goncalo3377/Tese/Document_Dissertacao/README.md

# README #

*EN Dissertation  LaTeX Template - Version 0.1 (JUL/2019)*

This template explains the main formatting rules to apply to a Master Dissertation work for EN.

**You can fork this repository to make your own dissertation based on this template.**

This template is based on MastersDoctoralThesis version 1.2 by Vel (vel@latextemplates.com) and Johannes Böttcher, downloaded from [LaTeXTemplates](http://www.LaTeXTemplates.com) in November/2015. Adapted to TMDEI/ISEP style (Dec/2015) by Nuno Pereira and Paulo Baltarejo (DEI/ISEP).

## How do I get set up? ##

Just fork the repository and use it. You will need LaTeX tools installed in your system, with the packages needed by the template (more details bellow).

### LaTeX Distribution

LaTeX is available for many systems including Windows, Linux and Mac OS X. Check the webpage for the LaTex project for more information: <https://latex-project.org/ftp.html>.

Make sure you have the following tools installed: **pdflatex**, **makeglossaries**, **biber**, **latexmk**.

### LaTeX Packages Needed

| Package | Obs |
|---|-----|
|babel|Required for automatically changing names of document elements to languages besides english|
|scrbase|Required for handling language-dependent names of sections/document elements|
|scrhack|Loads fixes for various packages|
|setspace|Required for changing line spacing|
|longtable|Required for tables that span multiple pages (used in the symbols, abbreviations and physical constants pages)|
|siunitx|Required for \SI commands|
|graphicx|Required to include images|
|xcolor|Required for extra color names|
|booktabs|Required for better table rules|
|inputenc|Required for inputting portuguese characters|
|fontenc|Output font encoding for portuguese characters|
|csquotes|Required to generate language-dependent quotes in the bibliography|
|cmbright|Default font: CM Bright, lighter sans-serif variant of Computer Modern Sans Serif|
|algorithm|Required for algorithms|
|algpseudocode|Part of algorithmicx package, required to customize the layout of algorithms|
|listings|Required for code listings|
|glossaries|Required to define acronyms and make glossaries|
|caption|Required for customising the captions|
|biblatex|Required for citations and bibliography|
|tikz|Required for creating graphics programmatically (can be removed if not used)|
|pgfplots|Required for drawing high--quality function plots (can be removed if not used)|

## Who do I talk to? ##

* Hilário Araújo (rocha.araujo@marinha.pt) and 
* Ricardo Moura (ricardo.pinto.moura@marinha.pt)

## Tutoriais: ##
*Texmaker: https://www.xm1math.net/texmaker/doc.html

*Overleaf: https://www.overleaf.com/learn

*Youtube:  https://www.youtube.com/playlist?list=PLB6oieQ9gzTRyQQJh8XPi1kHsNcpPyndk
