goncalo3377/Tese/Notas Índice.md

## 1. Introdução

### 1.1 Contexto Geral e Motivação

### 1.2 Definição do Problema

### 1.3 Objetivo da dissertação

### 1.4 Estrutura da dissertação

## 2. Enquadramento Teórico
### 2.1 Atuação Mecânica

### 2.2 Cinemática num Gimbal (Yaw-Pitch)

#### 2.2.1 Referenciais de Coordenadas
#### 2.2.2 Cinemática Direta e Inversa
### 2.3 Controlo

#### 2.3.1 Controlo Clássico (PID)

### 2.4 Geometria da Visão e Calibração
### 2.5 Algoritmos de Deteção
### 2.6 Algoritmos de Seguimento

### 2.7 Propagação Laser e Interação Atmosférica

## 2.8 Métricas de Desempenho

## 3. Estado da Arte

### 3.1 Sistemas de Seguimento a Laser Existentes

### 3.3 Deteção de UAV via Câmaras 
### 3.4 Algoritmos de Seguimento em Tempo Real
## 4. Metodologia

### 4.2 Modelação e Criação do Sistema Gimbal

### 4.3 Deteção

### 4.4 Seguimento e Estima de Estado

### 4.5 Controlo

### 4.6 Seleção do Sistema Laser

### 4.7 Validação

## 5. Resultados Preliminares 

## 6. Plano de Trabalho

Fontes: tese(Calvão Candeias, Gonçalves António, Afonso Rodrigues, Alves Rasinhas, Gemini)
