goncalo3377/Tese/Document_Dissertacao/frontmatter/listabreviations.tex

%List of Abreviations
%
\begin{acronym}[GPOS] % Coloque aqui a sigla mais comprida para alinhar a tabela
    \acro{BLDC}{\emph{brushless DC}}
    \acro{CSI}{\emph{camera serial interface}}
    \acro{UAV}{\emph{unmanned aerial vehicle}}
    \acro{SPI}{\emph{serial peripheral interface}}
    \acro{FDM}{\emph{fused deposition modeling}}
    \acro{FOC}{\emph{field-oriented control}}
    \acro{fps}{\emph{frames per second}}
    \acro{fov}{\emph{field of view}}
    \acro{PID}{\emph{proportional-integral-derivative}}
    \acro{DC}{\emph{direct current}}
\end{acronym}
