goncalo3377/Tese/Document_Dissertacao/chapters/ch6_Controlo/Controlo.tex

% Chapter 3

\chapter{Controlo} % Título expandido mais formal
\label{chap:Chapter6} 

O presente capítulo é dedicado à implementação do sistema de controlo em malha fechada do \emph{gimbal}, elemento fulcral para garantir a estabilização e a exatidão do feixe \emph{laser} contra \acp{UAV}. Para operacionalizar esta exigência de alta precisão num motor \ac{BLDC}, a camada base de acionamento recorre ao Controlo por Orientação de Campo (\ac{FOC}). Esta estratégia vetorial simplifica a dinâmica trifásica do estator ao transformá-la num modelo linear equivalente ao de um motor de corrente contínua, desacoplando o fluxo magnético do binário efetivo através das transformações de Clarke e Park e das suas respetivas inversas, as quais ditam as correções sob a forma de referências de tensão virtuais $V_q$ (binário) e $V_d$ (fluxo, mantido a zero).

Sobre esta fundação, a arquitetura proposta adota uma estratégia de comutação baseada em limites de erro para conciliar a rapidez de captura com a precisão absoluta de apontamento, alternando de forma automática entre dois controladores estruturalmente independentes. O primeiro estágio é governado pelo Controlador de Varrimento, encarregue de executar as trajetórias sistemáticas de varrimento do céu e de aproximar celeremente o \emph{gimbal} da vizinhança da ameaça assim que esta é identificada pelo modelo de visão. Por ser projetado com uma margem de estabilidade conservadora para mitigar dinâmicas oscilatórias fora do campo de visão da câmara.

A transição para o segundo estágio ocorre de forma automática assim que o módulo do erro angular de apontamento cai abaixo de um limiar predefinido ($|e(t)| \le \epsilon$), momento em que a arquitetura desativa o estágio inicial e comuta para o Controlador de Seguimento. Esta segunda estrutura apresenta uma parametrização significativamente mais agressiva que visa anular qualquer desfasamento cinemático residual, garantindo estritamente um erro em regime permanente nulo face a entradas em rampa de modo a fixar o feixe no centro do alvo. Para detalhar o desenvolvimento desta arquitetura, as secções seguintes abordam, de forma sequencial, o processo de identificação experimental em frequência, o projeto analítico dos controladores obtidos e a sua respetiva validação em bancada de ensaios.

\section{Modelação e Identificação}

A análise do subsistema de atuação requer a modelação matemática dos atuadores síncronos de ímanes permanentes que controlam os eixos da plataforma. Originalmente, a dinâmica elétrica de um motor sem escovas (\ac{BLDC}) é descrita diretamente no referencial trifásico ($abc$) através das suas equações de tensão:

\begin{equation}
    v_{as} = R_s i_{as} + (L_s - M)\frac{di_{as}}{dt} + e_{as}
    \label{eq:bldc_fase_a}
    \myequations{Tensão de fase A do motor \ac{BLDC}}
\end{equation}

\begin{equation}
    v_{bs} = R_s i_{bs} + (L_s - M)\frac{di_{bs}}{dt} + e_{bs}
    \label{eq:bldc_fase_b}
    \myequations{Tensão de fase B do motor \ac{BLDC}}
\end{equation}

\begin{equation}
    v_{cs} = R_s i_{cs} + (L_s - M)\frac{di_{cs}}{dt} + e_{cs}
    \label{eq:bldc_fase_c}
    \myequations{Tensão de fase C do motor \ac{BLDC}}
\end{equation}

onde $v_{as}$, $v_{bs}$ e $v_{cs}$ representam as tensões aplicadas a cada fase, $R_s$ é a resistência do estator, $L_s$ e $M$ correspondem às indutâncias próprias e mútuas das bobinas, e $e_{as}$, $e_{bs}$, $e_{cs}$ denotam as forças contraeletromotrizes induzidas. O binário eletromagnético total ($T_e$) gerado no entreferro é deduzido a partir da potência elétrica convertida:

\begin{equation}
    T_e = \frac{e_{as}i_{as} + e_{bs}i_{bs} + e_{cs}i_{cs}}{\omega_m}
    \label{eq:binario_bldc_completo}
    \myequations{Binário eletromagnético do motor \ac{BLDC}}
\end{equation}

sendo $\omega_m$ a velocidade angular mecânica do rotor. Quando o motor é acionado recorrendo à estratégia clássica de comutação eletrónica por condução a $120^\circ$, em cada setor de operação existem apenas duas fases ativas em série a conduzir correntes de igual magnitude e sinal oposto, permanecendo a terceira fase em circuito aberto. Sob este regime estabilizado, as variáveis elétricas e as forças contraeletromotrizes trapezoidais simplificam-se, resultando numa produção de binário linear e idealmente constante.

Conforme estabelecido no \emph{Springer Handbook of Robotics} \parencite{siciliano2016springer}, apesar de apresentarem arquiteturas físicas distintas, os motores \ac{DC} convencionais e os motores \ac{BLDC} podem ser descritos por equações dinâmicas virtualmente idênticas. Esta equivalência permite determinar o comportamento do atuador síncrono através de um modelo linear equivalente de corrente contínua:

\begin{equation}
    v_a = R_a i_a + L_a \frac{di_a}{dt} + v_b
    \label{eq:dc_eletrica}
    \myequations{Equação elétrica do motor \ac{DC} simples}
\end{equation}

\begin{equation}
    J \frac{d\omega_m}{dt} + B \omega_m = T_m - \frac{T_l}{r}
    \label{eq:dc_mecanica}
    \myequations{Equação mecânica do motor \ac{DC} simples}
\end{equation}

Nas Equações~\ref{eq:dc_eletrica} e~\ref{eq:dc_mecanica}, $v_a$ e $i_a$ são a tensão e a corrente equivalentes, $R_a$ e $L_a$ representam a resistência e a indutância vistas pelo controlador, $B$ dita o coeficiente de atrito viscoso, $v_b$ é a força contraeletromotriz ($v_b = K_b \omega_m$), $T_m$ é o binário motor ($T_m = K_t i_a$), $T_l$ traduz os binários de perturbação externa (carga) e $r$ indica a relação de transmissão mecânica. No protótipo desenvolvido nesta dissertação, os atuadores operam em regime de acionamento direto, ditando uma relação de transmissão unitária ($r = 1$) que elimina a necessidade de sistemas de engrenagens. Adicionalmente, devido a esta configuração mecânica de baixo atrito, às velocidades de operação reduzidas e ao amortecimento eletromecânico dominante introduzido por $K_b$, as perdas viscosas tornam-se numericamente insignificantes, assumindo-se por projeto que $B \approx 0$.

Embora ambos os eixos partilhem deste modelo fundamental de acionamento direto, as suas respostas dinâmicas reais diferem devido à distribuição cumulativa de massa na estrutura do \emph{gimbal}. Para efeitos de modelação, assume-se que as massas associadas a ambos os eixos se encontram geometricamente centradas em relação aos respetivos eixos de rotação, pelo que as discrepâncias nos momentos de inércia decorrem estritamente da diferença de peso entre os componentes suportados.

O eixo de \emph{Pitch} constitui o elo mais interno da cadeia cinemática e suporta apenas o elemento mais leve do sistema: o sensor ótico, o laser e o seu suporte concêntrico imediato. Como a massa em rotação é reduzida, o momento de inércia equivalente refletido no motor de \emph{Pitch} ($J_{\text{pitch}}$) é minimizado.

Por outro lado, o eixo de \emph{Yaw} (guinada) está posicionado na base da plataforma e atua como o elo externo que sustenta toda a estrutura móvel. Consequentemente, mesmo considerando a massa centrada, este motor tem de movimentar uma carga total consideravelmente superior, que engloba o peso combinado da câmara, do motor físico de \emph{Pitch} e estrutura central. Esta acumulação de componentes resulta numa massa global maior, traduzindo-se num momento de inércia significativamente mais elevado do que o do elo interno ($J_{\text{yaw}} \gg J_{\text{pitch}}$).

Esta assimetria traduz-se diretamente nas constantes de tempo mecânicas de cada eixo ($\tau_m \approx J R_a / K_t K_b$). Dado que as características elétricas e as constantes eletromecânicas dos motores são análogas, o comportamento dinâmico é governado pela carga inercial, prevendo-se que o motor pitch apresente uma resposta temporal mais rápida e uma frequência de corte mais elevada, enquanto que o motor yaw apresentará uma resposta visivelmente mais lenta, com maior amortecimento inercial e menor largura de banda.

\section{Identificação Experimental em Frequência}
\label{subsec:identificacao_frequencia}

A caracterização dinâmica de cada conjunto motor e encoder do \emph{gimbal} foi efetuada recorrendo ao método de identificação experimental por varrimento de frequências. Operando em malha aberta sob controlo de tensão, desenvolveu-se uma aplicação dedicada em \emph{Python} encarregue de automatizar o processo de ensaio, gerar digitalmente os sinais de excitação e realizar o registo síncrono das formas de onda. Este programa injetou um sinal de excitação sinusoidal contínuo na entrada de tensão de quadratura ($V_q$), com uma amplitude controlada para evitar a saturação dos condutores, monitorizando em tempo real a resposta posicional do motor ($\Theta$) através das leituras do \emph{encoder} magnético MT6835. A interface gráfica desenvolvida para a configuração do varrimento, visualização em tempo real e exportação dos dados temporais encontra-se ilustrada na Figura~\ref{fig:software_python}.

\begin{figure}[H]
    \centering
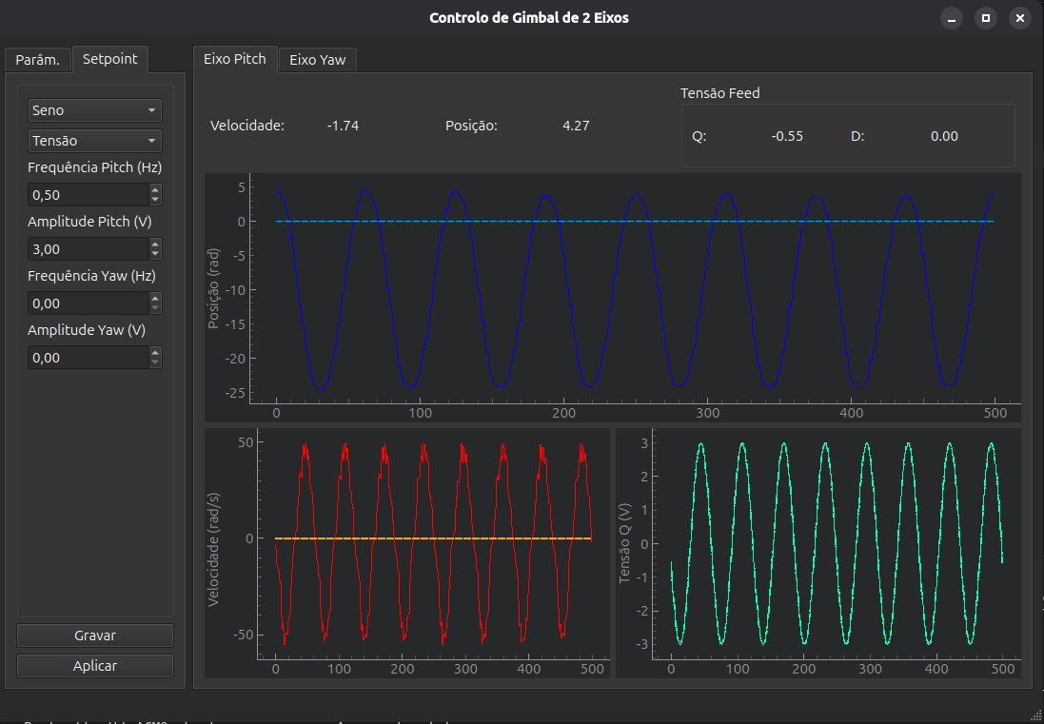
[picture p1: Document_Dissertacao/chapters/ch6_Controlo/assets/python_programa.png]
     % Ajusta o caminho e extensão da imagem
    \caption[Interface da Aplicação de Aquisição em Python]{Interface gráfica da aplicação desenvolvida em \emph{Python} para aplicação e registo de formas de onda}
    \label{fig:software_python}
\end{figure}

Os limites do varrimento foram condicionados pelas restrições físicas do sistema de medição. A frequência mínima foi selecionada de modo a garantir, pelo menos, uma década de leitura antes da frequência de quebra do primeiro polo, assegurando a caracterização correta do ganho em baixas frequências. Por outro lado, fixou-se a frequência máxima em $50~\text{rad/s}$ para o eixo de \emph{pitch} e em $10~\text{rad/s}$ para o eixo de \emph{yaw}. Acima destes limiares, a atenuação severa da amplitude impossibilita a determinação precisa da fase e da magnitude do sinal de saída. Para o pós-processamento e extração dos pontos do diagrama de Bode, a determinação da razão de amplitudes e do atraso de fase baseou-se no método de deteção da passagem da onda por zero. Os diagramas de Bode obtidos experimentalmente encontram-se ilustrados na Figura~\ref{fig:bode_identificacao_eixos}.

\begin{figure}[H]
    \centering
    % Subfigura Esquerda - Pitch
    \begin{subfigure}[b]{0.48\textwidth}
        \centering
        
        \caption{Eixo de \emph{Pitch}.}
        \label{fig:sub_bode_pitch}
    \end{subfigure}\hfill
    % Subfigura Direita - Yaw
    \begin{subfigure}[b]{0.48\textwidth}
        \centering
        
        \caption{Eixo de \emph{Yaw}.}
        \label{fig:sub_bode_yaw}
    \end{subfigure}
    \caption[Diagramas de Bode Experimentais por Eixo]{Diagramas de Bode obtidos por varrimento experimental.}
    \label{fig:bode_identificacao_eixos}
\end{figure}

A análise analítica das curvas de magnitude e fase da Figura~\ref{fig:bode_identificacao_eixos} permite mapear a ordem e a estrutura do modelo dinâmico dos atuadores. Em baixas frequências, ambos os eixos exibem uma inclinação constante de $-20~\text{dB/década}$ no diagrama de magnitude, acompanhada por uma fase inicial estabilizada nos $-90^\circ$ (ou $270^\circ$). Este comportamento comprova a presença de um integrador puro na origem, o qual decorre diretamente do facto de a entrada do sistema ser uma tensão (proporcional ao binário e, por conseguinte, à velocidade angular) e a saída monitorizada ser a posição angular do veio.

À medida que a frequência de excitação aumenta, observa-se uma inflexão na magnitude para um declive de $-40~\text{dB/década}$, acompanhada por uma queda progressiva de $90^\circ$ na fase desde a década anterior até à decada seguinte. Este fenómeno assinala a frequência de corte ($\omega_c$) correspondente ao polo mecânico do sistema. É de notar que, dentro da janela de frequências delimitada pelo ruído do sensor, não é visível qualquer transição adicional na inclinação ou na fase que denote a influência do polo elétrico. O polo elétrico localiza-se numa região de frequências muito superior, fora do espetro mensurável, o que valida empiricamente a omissão da dinâmica indutiva discutida na Secção anterior e confirma a adequação de um modelo simplificado de segunda ordem para a posição.

A partir da extração gráfica da frequência de corte mecânica ($\omega_c = 1/\tau$) e do ganho estático ($K$) em cada diagrama, a dinâmica de Laplace de cada eixo pode ser aproximada pela função de transferência genérica descrita na Equação~\ref{eq:funcao_transferencia_geral}:

\begin{equation}
    G(s) = \frac{\Theta(s)}{V_q(s)} = \frac{K}{s(\tau s + 1)} = \frac{K}{s^2\tau + s}
    \label{eq:funcao_transferencia_geral}
    \myequations{Função de transferência genérica do sistema de posicionamento}
\end{equation}

Substituindo os parâmetros específicos extraídos experimentalmente para as constantes de tempo e ganhos de cada canal, obtêm-se as funções de transferência numéricas para os eixos de \emph{pitch} e \emph{yaw}, expressas respetivamente pelas Equações~\ref{eq:tf_pitch_completa} e~\ref{eq:tf_pitch_completa}:

\begin{equation}
    G_{\text{pitch}}(s) = \frac{K_{\text{pole}}}{s(s + a_{\text{pitch}})} = \frac{254.9}{s(s + 19.51)} = \frac{K_{\text{pitch}}}{s(\tau_{\text{pitch}} s + 1)} = \frac{13.065}{s(0.0513s + 1)}
    \label{eq:tf_pitch_completa}
    \myequations{Função de transferência do eixo de \emph{Pitch}}
\end{equation}

\begin{equation}
    G_{\text{yaw}}(s) = \frac{K_{\text{pole}}}{s(s + a_{\text{yaw}})} = \frac{13.85}{s(s + 1.807)} = \frac{K_{\text{yaw}}}{s(\tau_{\text{yaw}} s + 1)} = \frac{7.665}{s(0.553s + 1)}
    \label{eq:tf_yaw_completa}
    \myequations{Função de transferência do eixo de \emph{Yaw}}
\end{equation}

Estas equações empíricas constituem a base matemática da planta, refletindo fielmente a resposta eletromecânica real de cada atuador, e serão utilizadas subsequentemente para o projeto, sintonização e simulação dos algoritmos de controlo em malha fechada.

%----------------------------------------------------------------------------------------

\section{Arquitetura da Malha de Controlo}
\label{sec:malha_controlo}

A arquitetura de controlo desenvolvida para o posicionamento do \emph{gimbal} assenta numa estratégia de comutação de controladores baseada em limites de erro. Todo o ciclo algorítmico em tempo real é instanciado no microcontrolador ESP32-S3, utilizando-se a biblioteca \emph{SimpleFOC}~\cite{simplefoc} para facilitar a abstração física dos atuadores e simplificar a execução do controlo vetorial de baixo nível. Esta abordagem permite segmentar a operação do sistema em duas tarefas distintas e sequenciais, otimizando de forma independente a fase de exploração do espaço e a fase de retenção precisa do feixe sobre a ameaça através de duas estruturas de controlo independentes.

O primeiro estágio da arquitetura é constituído pelo controlo de varrimento, cuja função inicial é guiar o sistema através de trajetórias sistemáticas de busca no céu. Assim que o algoritmo de visão computacional identifica um \ac{UAV}, esta mesma estrutura atua de forma rápida para aproximar o alinhamento ótico da vizinhança imediata do alvo. Esta arquitetura necessita assegurar um erro nulo à entrada de um \emph{step}.

A transição para o estágio subsequente ocorre de forma automática assim que o módulo do erro posicional instantâneo decresce abaixo de um limite de tolerância predefinido. Neste instante, o algoritmo desativa a estrutura em cascata e comuta para o controlo de seguimento. Este modo operacional baseia-se num controlador PI-D. Necessitando de uma resposta significativamente mais agressiva, projetada para assegurar um erro em regime permanente estritamente nulo perante entradas em rampa e uma resposta rápida por forma a cumprir com os requisitos de velocidade angular anteriormente referidos.

\subsection{Controlador de Varrimento}
\label{subsec:controlador_varrimento}

Para o estágio de procura, implementou-se uma arquitetura de controlo em cascata, cuja estrutura detalhada está representada no diagrama de blocos da Figura~\ref{fig:diagrama_malha_controlo}. Esta topologia permite desacoplar a dinâmica de posicionamento da dinâmica de velocidade do motor, o que garante uma maior estabilidade global ao sistema através do amortecimento ativo da malha interna.

\begin{figure}[H]
    \centering
    
    \caption[Diagrama de Blocos do Algoritmo de Controlo em Cascata]{Diagrama de blocos do ciclo de controlo em cascata.}
    \label{fig:diagrama_malha_controlo}
\end{figure}

Primeiramente, o erro posicional $e_{\theta}(t)$ é calculado através da diferença entre o sinal de referência desejado $\theta_{\text{ref}}(t)$ e a leitura atual do \emph{encoder} magnético MT6835. Este erro é multiplicado por um ganho puramente proporcional de ângulo $K_{p,\theta}$, gerando uma referência de velocidade mecânica $\omega_{\text{ref}}(t)$ que é submetida a um bloco de saturação de velocidade, resultando na expressão $\omega_{\text{ref}}(t) = \text{sat}(K_{p,\theta} \cdot e_{\theta}(t), \pm\omega_{\text{max}})$. De seguida, calcula-se a velocidade angular real do motor, aplicando-se um segundo filtro passa-baixas. O erro de velocidade resultante, definido por $e_{\omega}(t) = \omega_{\text{ref}}(t) - \omega_{\text{filtrado}}(t)$, é processado por um \ac{PID} por forma a gerar a tensão de quadratura de referência $V_q(t)$, que é limitada a 8 V para não aquecer excessivamente o motor. Passando em seguida por um bloco de transformada inversa de \emph{Park} e de \emph{Clarke}, que converte a tensão de quadratura $V_q(t)$ e a tensão no eixo direto $V_d(t)$ em sinais de comando para as fases $A$, $B$ e $C$ do estator. Por fim, estes sinais digitais são enviados para o \emph{driver} de potência, que atua a ponte inversora trifásica, completando o ciclo de controlo em tempo real.

Sintonia do controlador e ensaios experimentais em desenvolvimento...

%----------------------------------------------------------------------------------------

\subsection{Controlador de Seguimento}

Para o estágio de seguimento, implementou-se uma arquitetura baseada num controlador \ac{PID} direto. Conforme ilustrado no diagrama de blocos da Figura~\ref{fig:diagrama_malha_seguimento}, esta topologia prescinde da malha de velocidade intermédia utilizada no modo de varrimento. Ao processar o erro angular de forma direta para ditar a ação de controlo, o sistema obtém um erro em regime permanente estritamente nulo face a entradas em rampa.

\begin{figure}[H]
    \centering
    
    \caption[Diagrama de Blocos do Algoritmo de Controlo de Seguimento Direto]{Diagrama de blocos do controlo de seguimento.}
    \label{fig:diagrama_malha_seguimento}
\end{figure}

Nesta configuração, o erro posicional instantâneo $e_{\theta}(t)$ é injetado diretamente no algoritmo PI-D. Nesta topologia, a ação derivativa é aplicada exclusivamente ao sinal de realimentação de velocidade e não ao sinal de erro posicional. Esta estratégia visa eliminar por completo o fenómeno de \emph{setpoint kick}, prevenindo picos abruptos e saturações violentas na variável de atuação sempre que a referência de trajetória sofre alterações súbitas ou degraus gerados pelo algoritmo de visão computacional. Adicionalmente, procedeu-se à integração de um filtro passa-baixas digital de primeira ordem diretamente acoplado ao bloco derivativo por forma a reduzir o ruído da derivação da posição. A ação combinada dos três termos gera a tensão de quadratura de referência $V_q(t)$, cuja dinâmica é calculada para impor acelerações imediatas ao rotor e fixar o feixe \emph{laser} no alvo. Uma vez que a camada de atuação de baixo nível e as restrições elétricas do \emph{gimbal} são idênticas às descritas na Subsecção~\ref{subsec:controlador_varrimento}, o sinal $V_q(t)$ é igualmente submetido ao teto de saturação de $8~\text{V}$ para proteção térmica do motor, seguindo diretamente para o bloco das transformadas inversas de Park e Clarke (com $V_d = 0$) para a modulação física das fases do estator.

Apoiado na função de transferência identificada, desenvolveu-se um modelo de simulação computacional em ambiente \emph{Simulink}, apresentada na figura \ref{fig:modelo_simulink_Cseguimento}, para aproximar o comportamento virtual à realidade física do protótipo. O modelo operou com uma discretização temporal idêntica (0.001 s) à verificada no controlo físico e integrou não-linearidades estritas do sistema, designadamente os limites de saturação de tensão e a zona morta induzida pelo atrito estático presente nos rolamentos e nos pontos de contacto da estrutura fabricada em manufatura aditiva.

\begin{figure}[H]
    \centering
    
    \caption[Diagrama de Blocos do Algoritmo de Controlo de Seguimento Direto]{Modelo em \emph{Simulink} com controlo de seguimento.}
    \label{fig:modelo_simulink_Cseguimento}
\end{figure}

A sintonia final e a otimização dos ganhos do controlador foram executadas recorrendo à ferramenta \emph{PID Tuner} do \emph{MATLAB} para um sinal de degrau de $1^\circ$. Através desta plataforma, testaram-se iterativamente múltiplos perfis com o objetivo de priorizar a robustez do sistema, ajustando o controlador para minimizar a sobre-elevação (\emph{overshoot}) e evitar oscilações prejudiciais à estabilização da imagem. A velocidade de resposta do controlador foi incrementada progressivamente até que o sinal de atuação estimado em simulação atingisse picos de aproximadamente $6~\text{V}$. Esta escolha foi deliberada para salvaguardar uma margem de segurança operacional estável face ao limite de saturação física de $8~\text{V}$ do \emph{hardware}. Este processo de otimização permitiu encontrar o equilíbrio ideal, maximizando a largura de banda e garantindo uma resposta transiente extremamente rápida para acompanhar a dinâmica de fuga da ameaça, assegurando, em simultâneo, que a ação de comando calculada não force a saturação contínua do motor, prevenindo fenómenos de instabilidade.

Ensaios experimentais em desenvolvimento...

%\begin{equation}
%    G_{pitch}(s) = \frac{\Theta_{pitch}(s)}{V_q(s)} = \frac{K}{s^2 + \frac{1}{\tau}s} =\frac{0.0}{s^2 + 0.0s}
%    \label{eq:tf_pitch}
%\end{equation}

%----------------------------------------------------------------------------------------

% \begin{figure}[H]
% \centering
% \includegraphics[width = 0.5\textwidth, keepaspectratio]{chapters/ch6_Controlo/assets/distancia_ensaio_laser.png}
% \caption[A]{An }
% \label{fig:dis}
% \end{figure}
