goncalo3377/Tese/Laser.excalidraw.md

---

excalidraw-plugin: parsed
tags: [excalidraw]

---
==⚠  Switch to EXCALIDRAW VIEW in the MORE OPTIONS menu of this document. ⚠== You can decompress Drawing data with the command palette: 'Decompress current Excalidraw file'. For more info check in plugin settings under 'Saving'

# Excalidraw Data

## Text Elements
diodo
zener ^J5OYJXCR

diodo zener 10V 500mw c10ph ^5JbkGLzE

Laser 650nm 2.5V 100mA ^jTOGaJiw

## No Circuito ^ksLhM8Bf

0.085A ^e9tierrV

assumindo V = 2.5V no laser ^abNBvRrp

laser ^OEZp72vg

R ^D1ocZkRl

R ^x5MwzIPR

88 ohm ^zX6cLY8M

10V ^q7b1R25B

23 ohm ^KPugFBPV

+ ^YhcNs2ix

- ^SOucVlMJ

12v ^zMoHt8Yf

max 13.4V ^PxEOL6xE

%%
## Drawing
```compressed-json
N4KAkARALgngDgUwgLgAQQQDwMYEMA2AlgCYBOuA7hADTgQBuCpAzoQPYB2KqATLZMzYBXUtiRoIACyhQ4zZAHoFAc0JRJQgEYA6bGwC2CgF7N6hbEcK4OCtptbErHALRY8RMpWdx8Q1TdIEfARcZgRmBShcZQUebQBGAE5tHho6IIR9BA4oZm4AbXAwUDBSiBJuCABWAClNAGsAcQAZIwBRNNLIWERKqCwoTrLMbmceRIAGbQmkxJ4AdkT5gA4q

+KqANn4ymFGAZh5l7XmAFh545fmq7cgKEnVucamJvcTVqsSq+Zf4nmuiyCSBCEZTSR7/LoQazKYLcCY3CDMKCkNj1BAAYTY+DYpEqAGJ4ghCYShpBNLhsPVlCihBxiJjsbiJMjrMw4LhAjlSRAAGaEfD4ADKsFhEkEHm5SJRaIA6vdJI8EVLUQhhTBRehxRUETTQRxwnk0PEEWx2dg1LsjRN4QCINThHAAJLEQ2ofIAXQRPPIWWd3A4QgFCMIdKw

lVwE25NLp+uYroDQdtYQQxG462+b2WexOW1tjBY7C4aD4eaYrE4ADlOGJuJ85m89jbIYRmAARDL9VNoHkEMIIzTCOltYJZHKuj0IoRwYi4Ttp+YbT4TKrLSabJtlIgcer+wP4BHYykp7g9/B9239TCDCSONjENioIzZJioeITABqqCq1v0FFQ2DfOAFR1SgABUBkqW970fZ9SFfD8vx/P8AImIDuR5TgoEFQgn0eDdIAwnIADFcH0flLS/BFLygA

BBIhlCLdBgh5QYEXzKBzAIOiQUY6BTW5PQclwEMmD9NAE33W0cRBEMCHAq9IPYaCn31OC30/b8Jl/f9AOA21cCEKA2AAJXCHDxFQZEhAQA8RIACWBUFr1fFIITKSRQnkqBmhDHdu17BAigAX22EoygqCQACtQIAeUaXAakIKgqPgCzoAghERjQMYNg2bREgKuY9m+DZlxOeYEQosZEj2Y4zguK4ETuYgHmLE5asK5ZypOX43xq5YESBEEwWLNzIG

hDV8MRZEVQZHF8WJIkkH7CkqWjeksXm5lyA4NkOWyVjbT5AU1Q1REsW1JMZtleVFSu6VVRFNKtVTHVhD1A00xNM0LTTa0EXtKdnXHT0jp9BAxNQCTg1DLL0FweIo0HYhY3jPclQQY8jR4PYV3mdZJjYstCzuyF83LDgqw4Gs0A2KoTgmFYupLZs2w7LHUFPc9IQHWliGHTIDpBydp1nDn4gXJcVzXUrbO3XdE0hQ80S7TmAqoiCJGaUIXzpiYOH0

XhtCqT83y0miozAzX0G1sI4L1g2jZN+DzfQzDsNw4spsIqASLI/AKLG9Kr24hjKmYw6yaYDj3FD3ijLgATMOE1TIehqTSBkjg5OtiBbd179HbiZ2zf0C2EQMozTNYT3LNIay5YQBzhuc+JXMGzyBh8+X/LPQLShCoowsgCL0HqZhmkkABZZYACEeW5Ho0uo7k4bGC5tD2WYqleC4Ti+F5KtGHgcbq85LiD5rWtfHNtA2V5JhWPZF3iBnc0hIanPB

CuOBhCypuVGiOaTJ0AEiWiSFalJAZ0mAX0Hae1OSRzKMdIUT1KgvUlNdBAcoWoKmLEqLBp1noXVeraXUkhUZfSkj9WAf0pqAydC6AooNITelIhDVW6dmyw3DKkN6fNKHiXRkmTGqsLgTDmPfCRA1SwFk4KTMo5NCxUxpqgeYuMLhzGWO/cKbNghzl7tzMovMhwjiFswkWM4DGvklt+aWy5Za2i3H5KGwilZsCPKrLmNkLy5zxHiVAVZUDokIKIIQ

ag2CWwoF5fEASgkhLCREt2OQPYWR4N7TCftyLcCDtROO4cEAsW5OxTi+B8nMn4giQSUQRKkDTm4so0l/A5wUhIfxgSHwJOwOEoy3JK4mTMrXKyPilb2UciNFyfwO7MC8t3Fx3jgqhVtKPDAiQOJMFIO+ReqU+gZVtGvCWyREizCuIcRmGwJYsx2KMC4RxTjn0araK+eDUCLm0FmAqdiLlVBxicE4g1xnOSmfpX+k0CEPVgW0xaEDbTkigetSF6AW

S7XZIg9C/JUHqmIRKcFKocHXyuQIQhaCxQkKRn4Chn0jTfQpL9K09CaSMOFmDdh9TFbhR4RIXAexyUxipa49lAhRF/VONaXKiR/myIpgoyASjKzVgsvEdY3V4iNh0SPPRCBrHeP7MjAWo5cgWNtFOKx4tbHLlXA4qaziFaSXcZ4k86tfGtPQM8VY5cyFWxdRAN1VQPWsPduZPCXpMmkWyWgXJAxylMUKUg2V0dSnRr4onKpydalsrtY0zOzT8AxI

kL6/1ZR+nVyDWgYZjdm5fyNO3W0HkZld18o6vuiyh7LNVlCTQFZZ70GMqQFNF4dnMj2ZCNeZz8rjGOffZYFxcYSqPtldYtV7kNUvrdYs+N3kfCzAse+Gx8aJABS3b+IK/5wlxUAzaICIBgMWtyOFa1kaIugPA1FB10UnRJZqMl57sFrt4D+oh6Dv1kPepSuMVDISmlpbQ+lANGXAyNaw8GGaYbEDDFyk4vKUb8q4WUZMqsljtUWCVImcjGKEoYMT

eV1MLLtXSa/dqMjWbtn0RzHVsK9VmLHIhsoJqxZiPNfY9ccsXG4cgMrNjTrIQry5XGIQZE6QPk/AAXidp+DgD58A61xCBaJudQjMHkyGaCKm1NQ009p5JWFS28AycRMNAcckaxDvRXiEdikJtjq5volTbTVJTqJThDTIBNNkrm/TcmFMmdQKp4u6mLN2z6YZAZNcLLlqcWMo91bgUf07leOZTawgttKMPco7aWJT3oMoKooE8gpV6BIQI2AoiguW

vsm5GxJWQiqjwE4KR6oXyan+pVxpa2Au4DmH+p60AAKwU+m9S072rWgRtRkcDWSvq5F6DFgHSU4vuniv9FHAGPSxUB/bkJyGCNfDS80MGXZwYdAhtAE4WW+iC4K8onL4ZVCw9d4e3RB2oD2ACQekJ8NplyvMc48QNgn1I9KtAhMpXKIVWmTYCxVjHK67oljWrJN911XzfV5iXsAmKOTwHDWkXDq6CPdtmAqhTwoEYR0AAFYyEBydBQBCw3jotrES

0XN+OHexcYTCY5uRtQjPsSa8VJ9yeXvLS7Vs2geSzmwM6Zyz9nnP6vL1p5AA56xN2FXGMsCRB89jztQM4VVZ8V1DdwWmPr+63gfAudjiYcPD1Vt4EHCa/8f3zehW1nmy2EWXvWyi/aW2jo7c/edC7eGsH4pecd4lZ29uXUu6B67o3IM0IombR7QMmEvb5wRZDH3M0j2+1CE2f2cPBcRMK+lCxPidYo3KxiBwEeo5oxNsXPA91XCmi2PH2qFdkk44

LbjFfLH8fnML73ONxeS/Ex4lWhWRllBk+gPXnq9PesPwGlJNn0khvs/7QOznaLeYkGIHITAPOkBjlxB/6AyLEGILCVNQl01ysoBKtqtatuRQts5wsT8ksq5Bk0t65d9xNMs/c24ctFd618sVd2NRke4BV8BisKdNdKgABFE4fAZQHgAAVQQB5X10qCaxa1PUym4Gt1tAoh6mOC+GnTQNuCOwqjGyy3gnVShFazPQOwvTWyhXATD2MQj0fSj22g21

jzjV5ATyzy/WTyJQejTxlWmgel2w0JzzKCu35QL0aSLzoVLyZR4yr1ZRr1Q3Q3hg2Cb3AzQAB2gCBxBy6DBzwzbzUVyj3R3gmG7yo0Yh9xR2o1UQZm9y3jFxxw1UnwJyMRn2Jy40NQX2NQFzNRXw+EZjWGtRVzEwgDlx32mVmSwICgINKxWWMiMEwAoHfAAEdCA2h4gAANSQIiS4NoKARIOyR0OARobZanYokSVeXQiib4TglYX4VdZ3YsYQz+CZ

Mw8aUQmbYPBQ0BUPJbeFeQyQpFF9ZQ99TFM6DBH9HQ/BcQ07U44DXPClfPW7OlB7W0BhZ7N0SvXkavW1BwuGKEeYFw10dwpeR4UHDGDmeYb4FYH5U4fveRYsEIsjFRRVRYDYZYZYc4b4YMTVKfQnDjVIufdI94xfQXQTbHIXETb4pxLfJIxAiAOANgEMQkwoOnZkunfCUoCYcnSvMAVkroEfG4UoO3Lk3nAhDkKAWeYzEMZQSkyEbIYgCUukKUmU

lPMUmiUgFECgIEXAew20OUtUjUrUnUyEekgOZQOE1XZIqQJXArQxfuMAHw6o9tGoKoGKAATRqDaPRFPz3yB2DhULXmR2624DpmmO4LmOvh3mmEWCWFVVVXKjpkWPGwjSmkDzEPBzm02OvW2MgQfT5ifWRQQTfW2w/XUKTyMK0MO3mP/SuIMLLNITuI+lcJu2oWg2L3+hePg3LyJLew4WVLrzQ1+NwGWABL7Nbw5iWDiJXEbFhMYkxIiMpjRyNGhx

eESDpguCxMSPl1xJ5lnwNWZUhD4xJJyJqiSBhKpIdVtLv0UjvDYAAB0OAVIX9dM810AoI7yHzYIrNUlg0jpQ0b8nNnV78eICkilSN38ylP9k0k4ADU4jSs0s4WlnIIA3z7zHydN9JksS0hkECK0kzJkg461yjcDsCpdcCJIqi21KgZQjAABpHkfAHkGiRIZoOyE4XAYyNoisRIZgGiuyd8SKYYtKBg1M5gtAK4Y2G3MYOIXrB5cMl5EbX3CZSbE9

MFK4kPaQnY3MmBTMgszbFQlBWss4q4i46s9M/QxPIyhssDV0FYiAKDO7NshlJ7Ls17JDOw0c4zRwqERIEctw8nDw6nLw9XERcWTYP5FYKRGctMPvecpEtMQ4E4Y5AmcfbEmkonUxAk8ccnAHKnA3BSAU+nSoVseIDxAALXqGMnwC5zpx5y6A+MPOyKXFKnKlfgoxtRl1r2KOpK3MtMIobWIsqOCpK0ookGKrKoqqqroKHXyva2xlqk62tEZhmEmD

OCWEkqVQd0GyeWG1d1mCx091flX0UqBQDzWNQFmwhUzIWxhXD12LzJ0sOLRWLJOOxXLL0MrIJQAwstuOMLz1MMePuxLw7Ocv3OQS+I6p+PDESC2X4T5SbKKIhyNFymnW+HRKiuLAPVisXNfFH2OU+H5OWVSp6tpJMX5jSNBsgAaoExX2avxjOAPG6tKMAsqG9MgHIGPyQtZt5EDVrkv1/Ov3DUokAqTSf36HQqjjf0TUgu/1/xkMgH80AKotovos

YuYtYvYs4u4t4v4vAOzTCxfIgC5uLTgO4HSxwKbjwtQIIutIqO3NItEz3AoqIIkEwHfA2EkBOBlArHFp9JGMcFIk4HrOGEeHGBt1h1DNmKd2vnWCmiWNbglim1UrMtmiuuzNhTkPuv2OfSUKevjxLJuM0PepuirIz3MtLMst+vuP+pbIcssOBrLwps+PcohuWXr1wELTZuRn+38uBOLFBJCrEWCLF0WFXA30ozIxySDh7ziqNHyOCJFwown3ZmJv

SrJsyoKGyspwCryrjXCnbRijaFKrgGhyq2qu8JFMyNNWpqllXN3kxpwIdtl0ZsvNrRtoGrV3tI1z3sqAPqPpPulKmppxmpHUeGnSjOtBPinOtBWBt3vmmEZjDKjpeX3lN0+BOCzFeC6mKgIrwp4JEOm3Oo2KzuurlogHvRW3zMeqLLzpevOzepOxMtLpVEMp+s7qrqbNsvsqeKBshFeJco+LYXew8rbtnl8rwLBNVnSRzEbH3jnIlsR1QHvsUVCJ

npvlOVRNKkXqJqZp3PxL3JsIgCpuXxvuRrpgZovItNpP32KMs2fNzi00Syv2s15rs19gc1v2FsgtFqfNkXAqTRlr/z8zTVgsqFdvds9u9t1oQqgKQocZ8chGNtS1Npwoy31ErWWJrVywwOV3fstParwKdu/okCMDaI2GwGaFdOWCnkEt2WAeDtgzYNGHQf61kqQe4CmJXNXJ3XeBzCUcBFwdOoIYupTuIbTtuq0tWy2gOJzuodYTUILvodTyOy+v

LtYYgBMI4YBscqsLeNcrBubvEdboHPDHRDEYRr8L2FXHxmCNynRv9xnNUdVT3USr+EuY3OXp0eMV3NJ27IPKyOvpF3UXntYPtW3xfuk1zjRNQDYEkH0CiQNqhZhbhace/K9icayUcwjTvyTXczAqluAoqX7UhAVpCZbsgz1sgIReWGhdhZgJSxszNtIotsEKtrKP6vmWn1GLIsdqGsIKKfQEaPmE0HiGMj+FEcAb9PGLQGfhtwtwjrweeRYPmo+E

zAZmHx+GOuPQSbOuGYkKmazI0pzIoYepmbjzmfzteqDorOLs+prO+sLo2Zsq2brt4c7MbsEd7LJY5WOa5VbDOZb0RuB062/FxmUvkZJiNDHunuxqSFVSzHROCPedYxXrxIyv0YyL+avuMcBZmFFXMbBcsavIkHUnhdzhLZRYv1cYxY8YhZcwJZjVAt8fxbDkJegpqVJcOfJeiYNvLYwtgKSbLRSfNvSdbkyfQKIo5btqQO5YFEKcKokBorZz8CIl

njZxhoHRGJXlEtt1fhBeuWyh+Racd22qrKmKuAKkWF6wtxzDRM1dGkTqDzUtTsNfTruu0qzt0qOOepYcLoYeWbtdWYdb+s2Zru4fbNdZBoMY9ZQyOa8twA6Fhuw3hoDb8OnT+QmESsTfnIm3iPHopkedX3Qbpq0c3M+ZSLTZ+b2cpv+eze9wXGKnpvPILZIu6FzhxhpeRaPwNvY6Ra/MrfRfcYAtraApbYbZUJKS83ragv/3bcC1HIgMQsqB49pY

rkwpNsHYblSeZZQLHcBDfsnbycKJ5c/tbWdvQFnkdEaNIArBoraDaBOA4uWEdGWE0GcFbHmBqGaAAY3bSi3FIbXh+UkukoG0eUhEVexn4I/jwr3dWKGaIf1ZIc0uNY/aobNeQXmctcwW0P/eTrRB/besdYg3MNbJdbKD4fdfBs7e9bg6IjEaBKBx4H7vBz8NVWCLfCuBgew7QHKgeZjf3iWCWDRJI4+fBa+b0co/qpo6XJpoOHxraqM6fosZY7pI

ZPnzdHJ15I5IKs5Lp25M27AF+Ei7pyCtKHdAvvTLFIVMcF/lHLlKu6VK9aJVVPVLYE1JCDgsgD1Je7e+1NHJNJgDNMYmW76swNybtIdJGvQDsg2EaPoHoGIOaDaE0FAkSB5B5HoD2FdKqCSjgF2Alb86lZxptzOHlbkqK/6cEJ6gfbTJT0utGZffGeS/1c/dzvNdoezytaLt/RLpWYWc58K+pVA8BvA7K7dag8q6KM8sHKGMQ+7rp23pBO8IkeDI

lXSWXDkeUYnu65i7w4H1UQlgl3KkgZStI9G/I7XvTd+f5yzem6arF06zPIftHJKLN5W8ZKypZMp3ZLAB27qoFP27twKucB6mFL96uku8lJu8e4wDpHu6j6q6e7f31Ne8NNu7pGT5+4+5W9NPNOB/053znbK0qDaCqGYFKuUEdFdPmGYBihODaMaDYDYAlJgAoBOBopqYkAJ+3YanWqPa2rC+GwToEJQOp/WKffp9vSNcjxS9Nf0oy7oc57/Z54A7

5/JUbKdaF+2frusIzf2aEej6l/DEdDq57oa6a98PFj3VmO9zubRqxsH1pguDXzpjHqXuTbI7Ie+bW6o8Mam5sRm82Cw4+mXLR+p1Rd6FtbQ9Jd3hvU9504fe23Lkv70pxKojuXQeIKH1O6ik38cfaUtHzu6R9cBCfaaM9wNLvc0+xADPqn2j7/dAeH/EHjkwM7g8v687dAJnEYpQBHQbQIQLPDshtFEgxBZwERD2AVh5gdkNnHZA75MQxi27RsDr

yqhTAZKx7AflWVspx0Q6o/QhuPwS5jNZCb7SZlehZ6zN0uFrBfllw+rp5eemXfhOv3J52ULCDTCDg3XF4HNJebdGoCf3l691eA5/IVBzAuToklgQRO5q/CjYqMY2bXCRJ8E67MYRuEA3RhR2/6Tcbe//O3qiVXKoCQBzvZ+nELKBQDv+G3L3ggN25IC4BKxUoCfAwFgAPiSICPoqXj5FF8BdQwgQjSiBJ9vuVAogV91IG/dqBWIAHrn05b0CbSlj

Qvisl+A1B3wjoYgpQSIhwBSqrpCsNgGcA1AEAMUWeI0TsgLx8e0g2aq+DHrF5yopPNpmPyi6U9bKqZE4bTxGbaCGeugiZpQ1n7HF8ui/JZsv1y7XErBIGdhhv0LwlcHBovSDrv1sL78iBh/LlO31l78p6u1ORrkrwHosFTgBUIjrhx7xphYcvXB/q+BhyxEX+SbfHCm3iEW8JuxJRqiLkuZPxbK+TIouAOW55CmSBQuAd7196YCGRbJAqiH127nc

VS2AggeQJwGjkahbQ7oVny6Ep8yBvQnPkD0GH59bSow9tPUBgBERBQMofQNgD2D1BsAjoOyM4CED1FSqhAegHAB8rbD9QhPNVGHXGBHCT20dO9l+AyEXDNB7w9SpP1fb3CTWMeVnsYPZ6GEXh2XN4VcLy72sCuwHH4cV1rr/DIA5XZwSCNcE+t4YzQDwdJjP5wjmu4sHMCfAw6HAESCjHeBiP15At6YxyaIbjliHLdSaJORISSIBbe4GYvwMNvbS

yFLdOWdIj3l0H25MjEBrItAQVS+CVDqhrQ8UryLwGx8hxRAwUbRHaHijOh6fScT0KIE0CBhU7K0tk2GELJeWjpSoDvGWDGQOAlBGKFZ1bBs5iCbAZwDRQmCzxEghARoK6UkFct/OLBCRGHVWBWjlBEZHGLaMGZJ0AxGIZ9i6MZ7T9meqXOfiYI55mCbWFglfp8KsoPFN+pXSMWLyBFN0YxLeMEfDGqaQimy0ItJD4LHJiJnmsOfeHf3Dbml1g2Yv

XhZFeArhYcuMV/to1d7ljyaBjIxrbxFxnAfkjiJ3tHxpHNjVu9I2AWyK96dj+JXQZwGsDKFgBRJQktsZTlEnviZJJwPsVgMHFNC+Ro4loSQLFFziGhM44UX9z6G0DXeQw22kVnXGQ8IAewCzpgGc4fh6g7UIcjUAAD6pVYyMZA2BQBMMJo+8Quk6xBc++oXMoOF1eTAC1BgvbVnFy0FXpEuU/PYoBMeHfsgxvo8wboROzPC1+1lWwVw2F5OUnBiE

6Dln1QlQgKwiY32thJTEX88Jh3D4KGzuZ/I8xiqb8CgPWC0TTeOQ83hWKZJJCl8LEmsa8Aw4FEZ2YA7IbSN4mtjSg7YooWH2EmClFwQfdAZyMmncjlJ13ZoS3kaHLSBRA4ygVOO0kUDZxWfBcVKKXFGSwecoyoK6UkDYAKwzAHgIQBGASst2uwsYB8HWq1RFB/fAKYP1tF4MHRurH8RP0WzRTM6sUj0UYIIjz9QJ5xHLt+NSnWD0poUsMWB2yk78

rewIz1qCLboxR/Wn2QNjjDFR0w3gdzPBtG0xG/AaJpUbRHiJxKWkGJ69RCcxJSGsToSj4pjmlWZoSAAA1KW29ScyK2LjATv+SxaeMpOuLJtpJ1E7ScgmMFOTtHwU4xNKgPMvtvS2wqadh2ltXTsuInYf8qRxnCHmZwgCCgYoQgbAO+HwBTx3B90w3BAFHTPTGms9ZIB10QbWiXkRwc4AVH2qxs34FGEKfcxUqPsnRv4gGa6KZ4GCgJTwhKWBO562

t3hMMr4TYPhkhZ7BzxRwcjJ/55ThGcYqEGzixmdVA2qqLeNolDbCFURRoYAcTNUSEY0S2iAmYTRalliv+HUqsbR06xw4fklIoaZy2sbOAuZSFLubzLSRVtBOgs4Tji1jSv4/GkFBOG2wCx1Is+ssg2r3MVlYV4CKspliOzTDqzjpjAikh1VOnFMp4bAOyFAGWCukthPnWpv6WPiolYG9srgpHSdlKtpgD8GqIcAuQHBp0X0z8X7O/HOjA5/4mKSH

Lik0MY57wxhpYNMGwyYJvw8MUnIBE5SUZSEtGbGLg7EFs5yvbGNOm0QSx6YwQjIWXP7lVA1g+RauTEPf70T65jdemULiaotUCFuHbiUuOsa/B6A3cyoEwr458z+abjAWULWHmQURZEtceVJ0nkydp5MHLtjmh7Y8BmFqnftgyyHary1ZeDTeVrIW74FTJestnJgDaAxRmgGwLRbeIekgNsohwfYX9CXS3yFWf6DdKiViJbp74hwX4LaI3iFQXFri

gqDrx+nxdIpOgskBnXfbAzCyaXMGSBJ9ERzQFkE8BbHLhnNkoFiMnZvwy9AS8UJbdLmutGuznNxY17P4KjTIkkS3m9/VRGFUuDol6xCRUsZyxpmW8f+lC81IuDpinAx69Cy0tY30C4BMAr4WqCcHXaXYvUSFVpe0vtxdL2F9UhIG4rGXCEfY1bITnvijR8LR5eLMWfHF8zEtgm0sogXPNzj9KOl2gIZTIqVnLzaSfnNedlmtorjjJhy1RbvLHgyh

JAbQWeEYGaBc0vBkrbdjlAowUQMxL4j6VWQPgJAkgmwFYNc36gfyNBv0n+TdTuHBzo8gS4Cd6LrJhKoZ1rD4ZEugnV1YlWU+JRVxcHJKM5uAQUKgvhFGh1g98FavkuImMQaodU9ppmGfjmia5sQxlm1MYl0y/+VC74BA1FQZCmlVjXOMZDaBEQaIpVNoMZFQBtAkQAAQ9QC4BUAggTQIEClWNFrIYgOCKEFQCBBWASIAAFfUwrAzAVAHAAADPeqt

8iwokB8qBVQqkVWKqgCSrpVsq+VbgEVUIBlVUqvVeqpbBQBtV5oVVYauNVKRIkfcn8mfi4WC1I0dbcWfws16CLxZwiyWbJxnnycKWinM1fysFXCrRVEqqVTKrsAOqnVLq1Ve6q1U6qfVRq1ACar2VLzkmK86dtpwyZKKZRrUzITvIHjgAWEUIOAHAGFBixuAYUaAECCyCQQOQO4bYAwEIAIAKAs8PxfoPxBo9Z1p8soN0nVIHRHQ/QfQMKDp43C/

x8tEQIghXWZBJ1egh4SDLS4QBF1u61dURHBmhKR1Z65dauvXVJTLiC6ndXesyAPrAxgHIwqepfU5A91+gYyCGKK7fql1v61dTFETk8Nt1IGjgRer/Khqb1P6mDZkCIg81+5CG6DX+q8gjzG2z6jDfes2l7TlSwG89ZkDaA6TNJ7aDkBqSGDEbX1Zcb7qBF9LrQaNt60DchvBgAaNQuGRENgBRACg2iE2emHfFeCJUGwqJNiSOuYC8asQ+AG8RjSm

Arg4cOYFYC8B3j1iIARgRvnCz8pkwCA1kdeV8GeZVACCtGtjf+q7r8p1myMGjdSBICotbMI62zcQGFAIBE4Q8+CSQH3loYyNuATQMEAJEebp1OmsoLPCxDtpSAygckAAAoMS1AXgAnXi0VRzqxsAAJTchTIygQMByHoKRbcAMW6crwAK24y4tCmtLSZtY1YQsE4GjiJwDRjsoEFpkUMJnHj6lZsgvm/zVWtpLYAiAbmuuNWogDZwB1GnWksICgAE

9htCIVpaQDRDWd2EnWybUOqYA+a/NHMYZCZrsCRRnVuQQUNnDgBeaEAy2jraNyhDNYDRCAUCI3yqrBbcq6CDIKdvkRVIhASIAwIxupzUj25S470AYEFB3aath0vJqEFoinbGAF2rELahM2OBmA7Wn8c/ivBTxsgQgAviZ2CXhAe1POIKEAA=
```
%%
