goncalo3377/Tese/Document_Dissertacao/main.tex

% Modelo da Dissertação de Mestrado da Escola Naval
% TMDEI Thesis EN Style
% 
% Baseado em MastersDoctoralThesis Version 1.2 by Vel (vel@latextemplates.com) and
% Johannes Böttcher, downloaded from (21/11/15):
% http://www.LaTeXTemplates.com
%
% Autores:
%  Vel (vel@ latextemplates. com)
%  Johannes Böttcher%
%
%  Adaptado para Thesis EN Style (JUL/2019) por 
%  Hilário Araújo (rocha.araujo@marinha.pt) 
%  Ricardo Moura (ricardo.pinto.moura@marinha.pt)
%
%%%%%%%%%%%%%%%%%%%%%%%%%%%%%%%%%%%%%%%%%

%-----------------------------------------%
%    CONFIGURAÇÃO INICIAl
%-----------------------------------------%
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
%     maxnames=25, %number of names in List of references
%     maxcitenames=2, % number of names for textcite command
%     autocite=superscript
%]{biblatex}

% numeric citation style (e.g. [1], [1-3])
%\usepackage[style=numeric-comp,sorting=none,backend=biber]{biblatex} % Bibtex backend with the numeric-comp citation style (numeric citations, bibliography ordered by appearance)

% alphabetic citation style (e.g. [Buendía10], [Buendía10, Arcadio40])
%\usepackage[style=alphabetic,sorting=none,backend=biber]{biblatex} % Bibtex backend with the alphabetic citation style (alphabetic citations, bibliography ordered by appearance)

\addbibresource{mainbibliography.bib} % O nome da base de dados da sua bibliografia

\makeglossaries % cria o glossário

%----------------------------------------------------------------------------------------
%	INFORMAÇÃO SOBRE A TESE
%----------------------------------------------------------------------------------------

\thesistitle{Desenvolvimento de um Sistema Gimbal de
Seguimento Visual para Neutralização de UAV
Utilizando Laser} % Escreva o título da tese, pode referenciar o titulo ao longa da dissertação utilizando o comando (\ttitle)

\thesissubtitle{ } % %Escreva o subtítulo da tese, pode referenciar o titulo ao longa da dissertação utilizando o comando (\subttitle)

\author{Gonçalo José Silva Ribeiro} % % Escreva o seu nome completo, pode referenciar o autor ao longa da dissertação utilizando o comando (\authorname)

\authorshort{Gonçalo Ribeiro} % % Escreva o seu 1º e último nome, pode referenciar o autor ao longa da dissertação utilizando o comando (\authorname)

\subjectarea{Engenharia Naval Ramo de Armas e Eletrónica} % Identifica a tua especialidade: Engenharia Naval Ramo de Armas e Eletrónica, Engenharia Naval Ramo de Mecânica, Marinha, Fuzileiros, Marinha e Administração Naval
%poderá referenciar-lo ao longo do seu trabalho com o comando (\areaname)

\supervisor{Bruno Duarte Damas} % O nome do seu supervisor, isto é usado na página da contra capa,  poderá referenciar-lo ao longo do seu trabalho com o comando (\supname)

\supervisorshort{Bruno Damas} %Nome do seu orientador (1º e último), isto é usado na página da contra capa, poderá referenciar-lo ao longo do seu trabalho com o comando (\supsname)

\cosupervisor{Vitor Rodrigues Viegas} % O nome do seu co-orientador, isto é usado na página da contra capa,  poderá referenciar-lo ao longo do seu trabalho com o comando (\cosupname) (comenta, se não tiveres co-orientador)

\cosupervisorshort{Vitor Viegas} %Nome do seu co-orientador (1º e último), isto é usado na página da contra capa, poderá referenciar-lo ao longo do seu trabalho com o comando (\cosupsname)

\keywords{Palavra-chave 1, ..., Palavra-chave 2} % Defina até 6 palavras-chave que descrevam melhor o seu trabalho, e poderá referenciar-las ao longo do seu trabalho com o comando (\keywordnames)

\conkeywords{keyword 1, ..., Keyword 2} %  Traduza as palavras do resumo e coloque-as aqui(\conkeywordnames)

\university{\href{https://escolanaval.marinha.pt}{Escola Naval}} % Nome da universidade e endereço web, , e poderá referenciar-la ao longo do seu trabalho com o comando \univname

\department{\href{http://department.university.com}{Departamento Ciência e Tecnologias}} % Nome do departamento e endereço web, e poderá referenciar-la ao longo do seu trabalho com o comando \deptname
% Classes e respetivos departamentos:
% EN-AEL E EN-MEC - Departamento Ciência e Tecnologias
% AN - Departamento de Humanidades e Gestão
% M - Departamento de Ciências do Mar
% FZ - Departamento de Ciências do Mar

\thesisdate{Alfeite \\ \the\year{}} % data da impressão da tese, pode referenciar a data ao longa da dissertação utilizando o comando (\tdate)

\hypersetup{pdftitle=\ttitle} % Set the PDF's title to your title
\hypersetup{pdfauthor=\authorname} % Set the PDF's author to your name
\hypersetup{pdfkeywords=\keywordnames} % Set the PDF's keywords to your keywords

\begin{document}

%----------------------------------------------------------------------------------------
%	PÁGINAS INICIAIS
%----------------------------------------------------------------------------------------

% Inclui as páginas iniciais da sua tese
\input{frontmatter/frontmatter}

%----------------------------------------------------------------------------------------
%	CORPO DA TESE
%----------------------------------------------------------------------------------------
\pagestyle{thesis} % Colocar os cabeçalhos nas páginas com o estilo definido para o corpo da tese

%Introcução - Obrigatória
\input{chapters/introduction/introduction}
\input{chapters/Enquadramento_teorico/Enquadramento_Teorico}
\input{chapters/Estado_da_Arte/Estado_da_Arte}
% Inclui os capítulos da tese como das respetivas pastas separadas por cada capítulo
% Uncomment os capítulos à medida que vais criando novos.
\input{chapters/ch5_Estrutura/Estrutura}
\input{chapters/ch6_Controlo/Controlo}
%\input{ch5/chapter5}

%Conclusão - Obrigatória
\input{chapters/conclusion/conclusion}

%----------------------------------------------------------------------------------------
%	BIBLIOGRAFIA
%----------------------------------------------------------------------------------------

\printbibliography[heading=bibintoc]

%----------------------------------------------------------------------------------------
%	APÊNDICES e ANEXOS
%----------------------------------------------------------------------------------------

% Incluir os apêndices da tese como arquivos separados da pasta (appendices)
% Uncomment as linhas para teres à medida que fores criando apendices.

%\appendixfile{appendix1}%
%\appendixfile{appendix2}%
%\appendixfile{appendix3}%
%\appendixfile{appendix}%

% Incluir os anexos da tese como arquivos separados da pasta (annexes)
% Uncomment as linhas para teres à medida que fores criando anexos

%\annexfile{annex1}%
%\annexfile{annex2}%
%\annexfile{annex3}%

%Imprime no documento os anexos e apendices.
\printappendixes
\printannexes

%----------------------------------------------------------------------------------------

\end{document}
