goncalo3377/Tese/Document_Dissertacao/annexes/annex1.tex

% Anexo 1

\chapter{Escreve o título do anexo} %

\label{Annex1} % para referenciares o anexo em alguma parte da tese usa o comando \ref{Annex1}

Os Anexos são conjuntos de documentos não elaborados pelo autor do trabalho, mas que serviram para a sua elaboração e facilitam a sua compreensão. Podem ser, igualmente, tabelas, quadros, gráficos ou organogramas retirados de outros autores e obras, mas também textos diversos ou imagens.
