goncalo3377/Tese/Document_Dissertacao/frontmatter/assets/generate_contrapage.odt

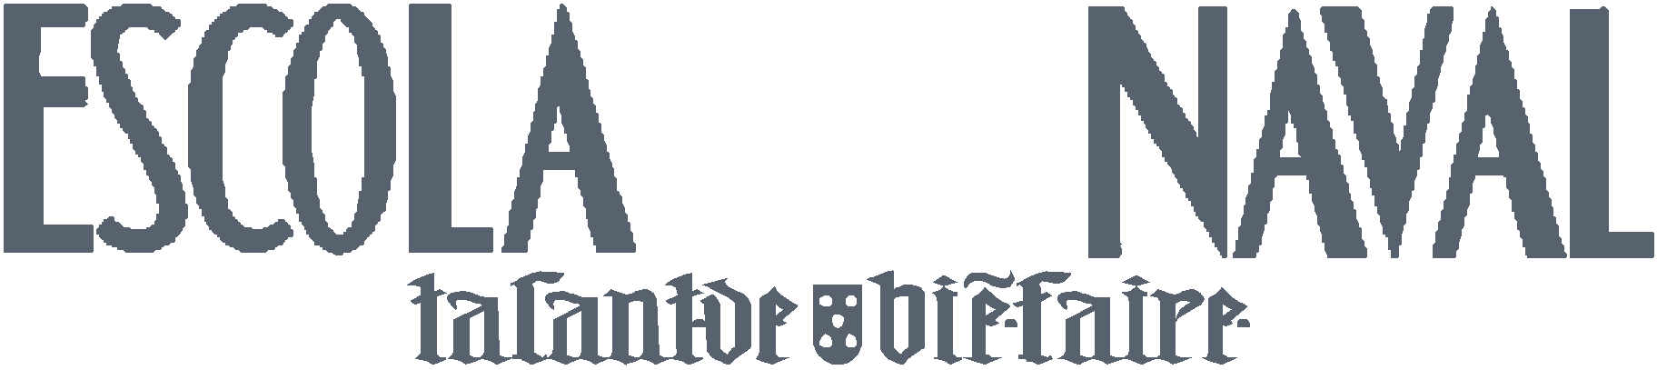
[picture p7: figure]
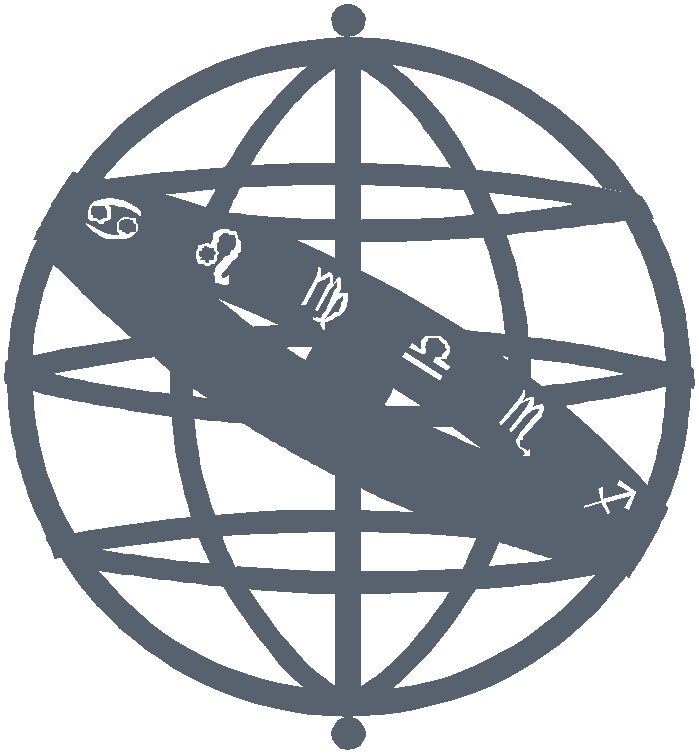
[picture p8: figure]
