goncalo3377/Tese/plano.pdf

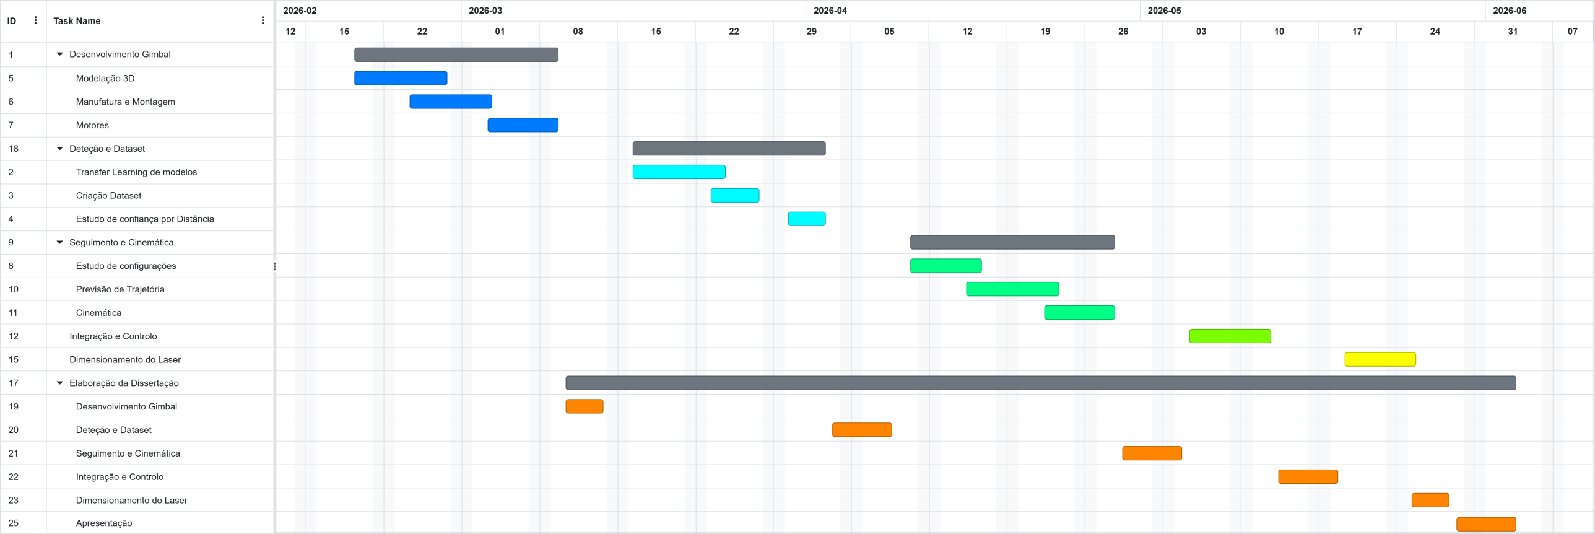
[picture p9: page 1]
