goncalo3377/Tese/Document_Dissertacao/chapters/ch6_Controlo/assets/velocidade_angular.pdf

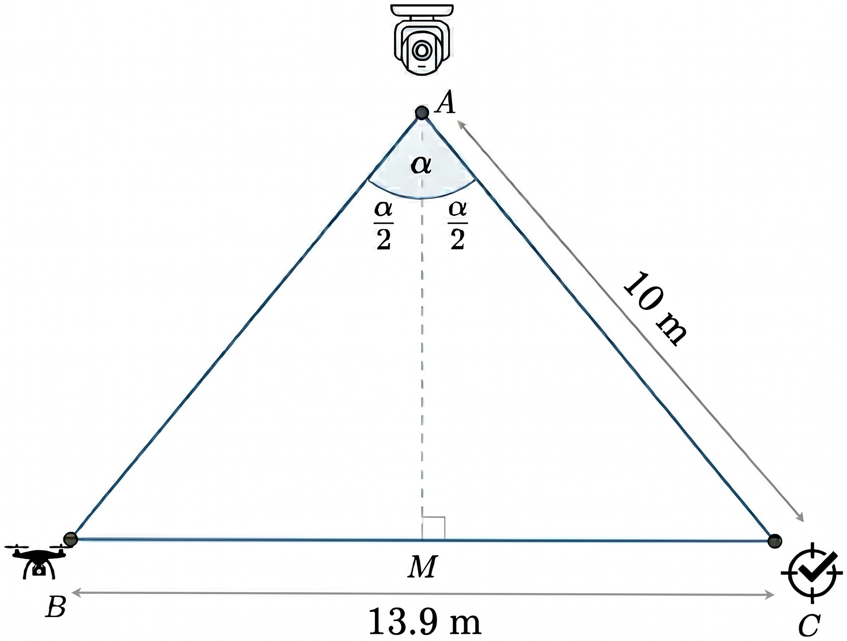
[picture p10: page 1]
