goncalo3377/Tese/apoio/697440495_226594390_1706x960.webp

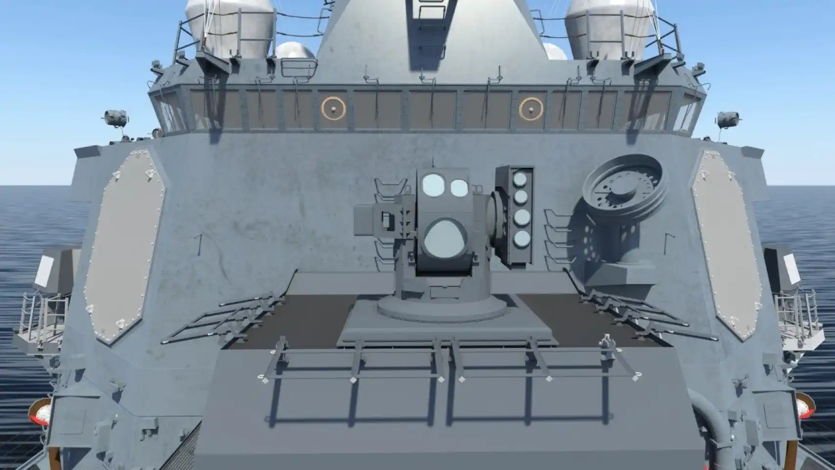
apoio/697440495_226594390_1706x960.webp
