goncalo3377/Tese/apoio/Gemini_Generated_Image_7msdzy7msdzy7msd.png

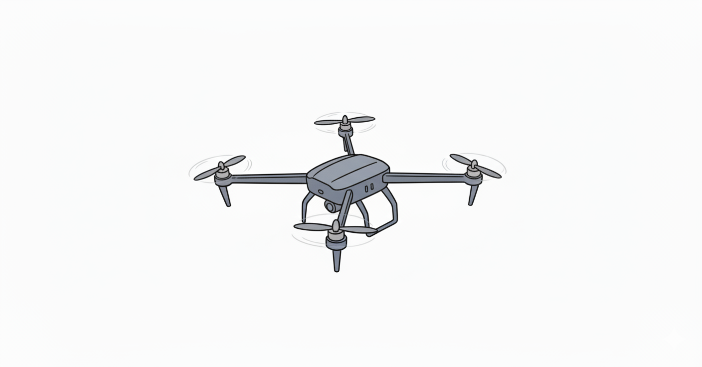
apoio/Gemini_Generated_Image_7msdzy7msdzy7msd.png
