goncalo3377/Tese/apoio/Gemini_Generated_Image_97b5z297b5z297b5.png

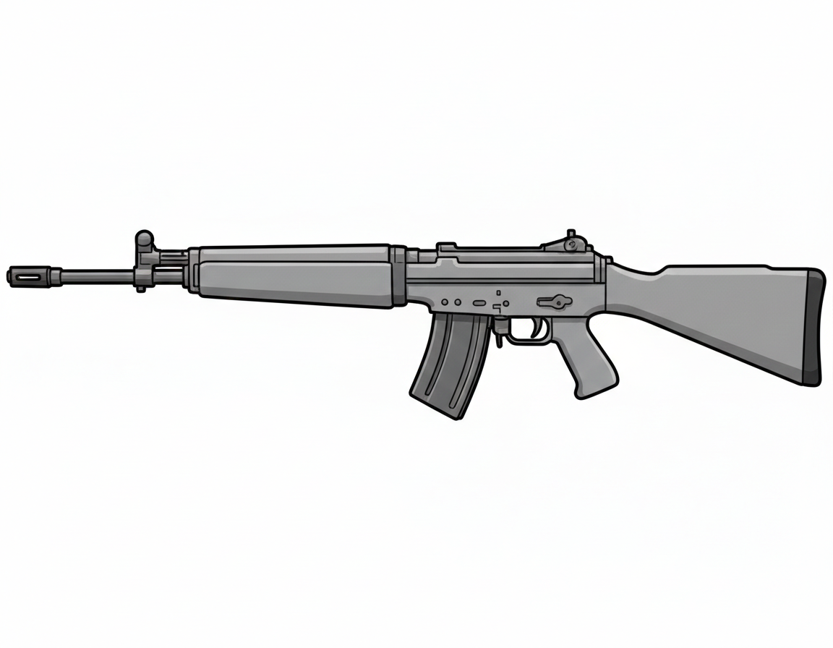
apoio/Gemini_Generated_Image_97b5z297b5z297b5.png
