goncalo3377/Tese/apoio/Gemini_Generated_Image_tf99y3tf99y3tf99.png

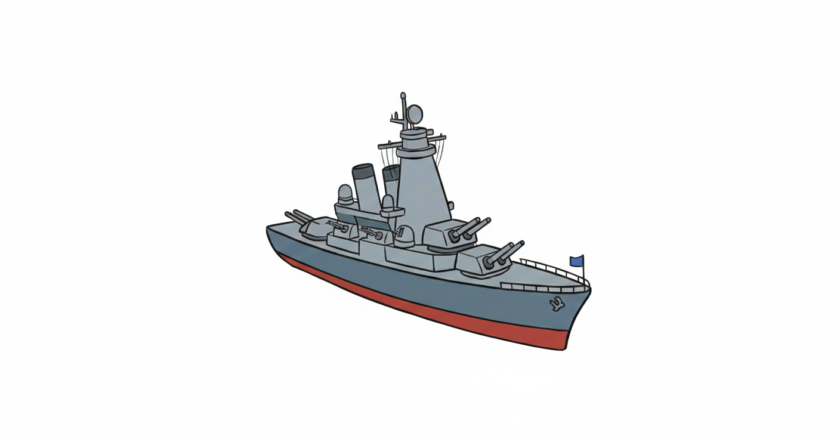
apoio/Gemini_Generated_Image_tf99y3tf99y3tf99.png
