goncalo3377/Tese/apoio/Gemini_Generated_Image_zdujozdujozdujoz.png

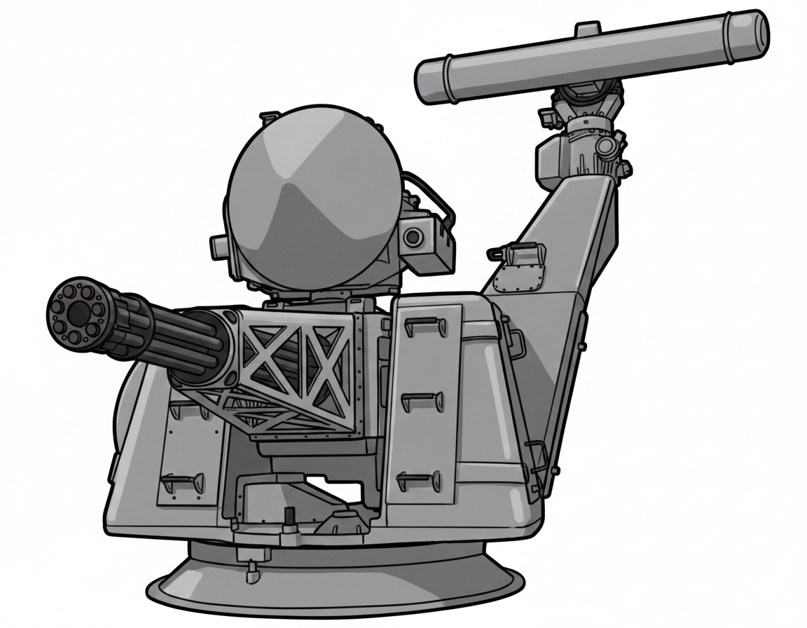
apoio/Gemini_Generated_Image_zdujozdujozdujoz.png
