goncalo3377/Tese/apoio/images.png

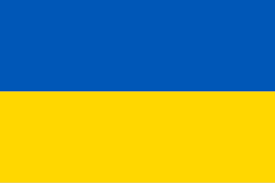
apoio/images.png
