goncalo3377/Tese/apoio/Pasted image 20251227100504.png

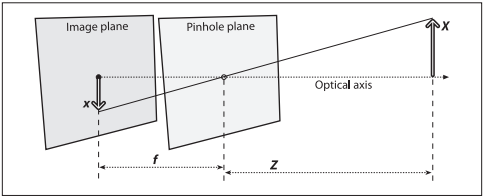
apoio/Pasted image 20251227100504.png
