goncalo3377/Tese/apoio/pitch-yaw-roll.png

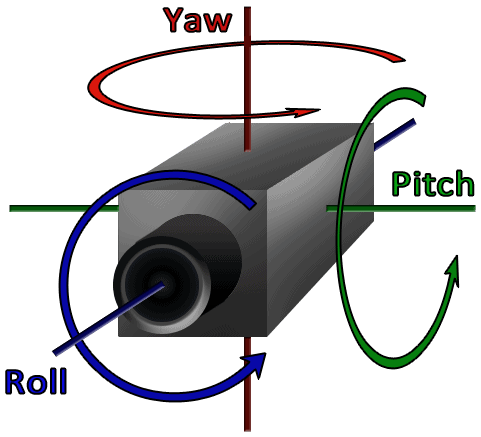
apoio/pitch-yaw-roll.png
