goncalo3377/Tese/apoio/WhatsApp Image 2021-10-25 at 09.07.15 (1).jpeg

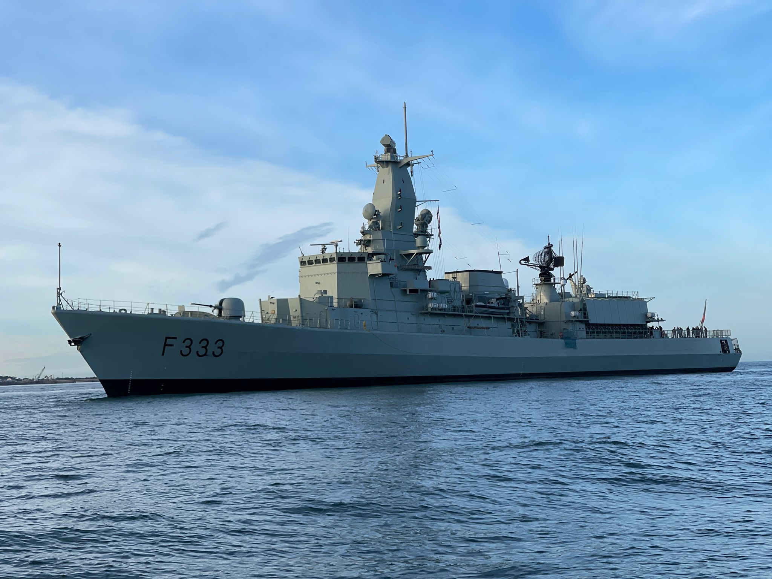
apoio/WhatsApp Image 2021-10-25 at 09.07.15 (1).jpeg
