goncalo3377/Tese/apoio/WhatsApp Image 2026-02-01 at 21.15.11.jpeg

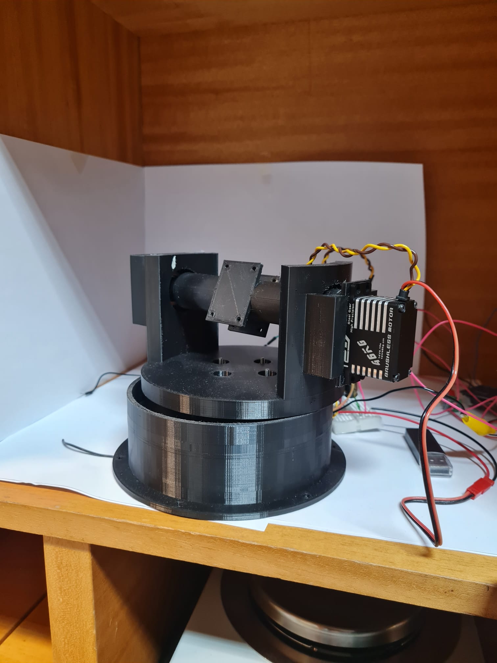
apoio/WhatsApp Image 2026-02-01 at 21.15.11.jpeg
