goncalo3377/Tese/Document_Dissertacao/chapters/ch5_Estrutura/assets/sistema_montado.jpeg

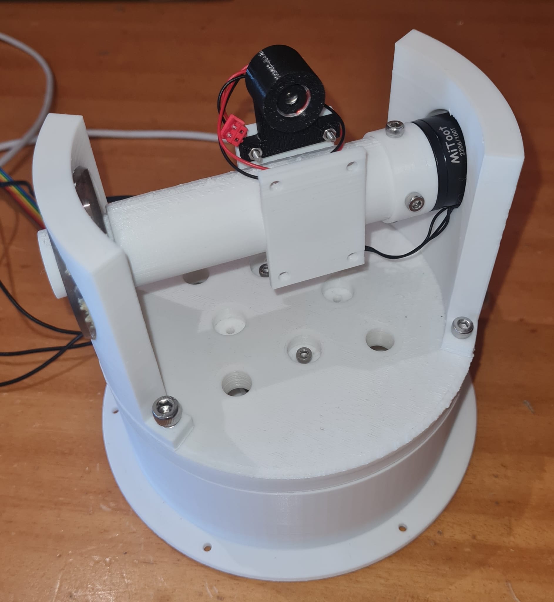
Document_Dissertacao/chapters/ch5_Estrutura/assets/sistema_montado.jpeg
