goncalo3377/Tese/Document_Dissertacao/chapters/ch6_Controlo/assets/distancia_ensaio_laser.png

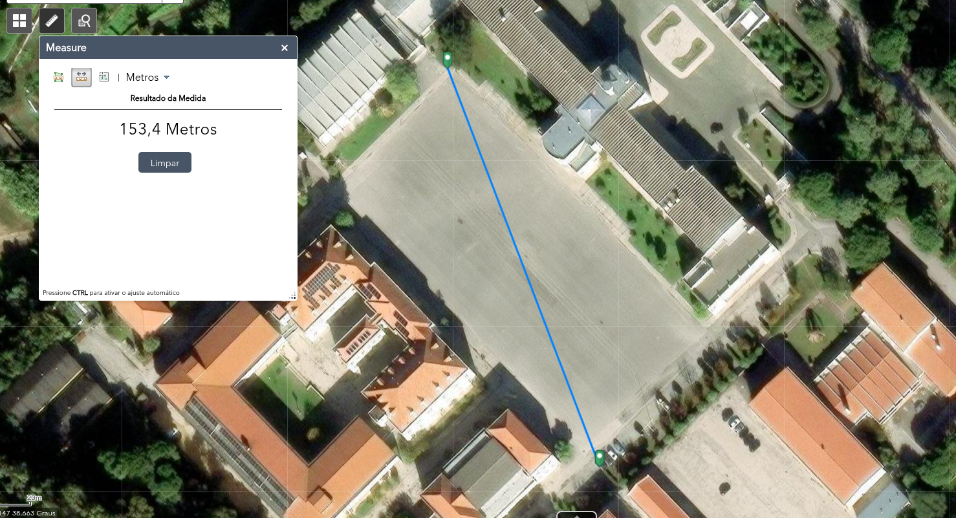
Document_Dissertacao/chapters/ch6_Controlo/assets/distancia_ensaio_laser.png
