goncalo3377/Tese/Document_Dissertacao/chapters/ch6_Controlo/assets/resolução_max.png

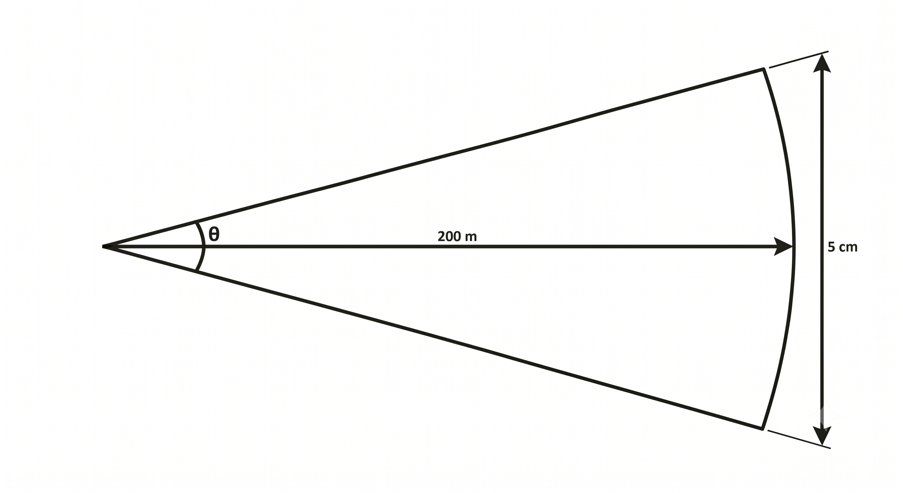
Document_Dissertacao/chapters/ch6_Controlo/assets/resolução_max.png
