goncalo3377/Tese/INFO_Material/Características Motor Mitoot 2206.md

14 polos (supostamente)

Resistência entre bobinas:
- 1-2 = 17.7 Ohm
- 1-3 = 17.7 Ohm
- 2-3 = 17.7 Ohm

Temperatura max parado:
	Temperatura ambienre: 19º
- 3V -> 32º
- 4V -> 55º

Determinar KV do motor
tensão na fase (V) -> velocidade max (rad/s)
0.1 -> 0
0.2 -> 0 
0.3 -> 0
0.4 -> 5
0.5 -> 9
0.6 -> 11
0.7 -> 14
0.8 -> 16
0.9 -> 19
1.0 -> 22
1.1 -> 24
1.2 -> 26
1.3 -> 29
1.4 -> 31
1.5 -> 34
1.6 -> 36
1.7 -> 39
1.8 -> 41
1.9 -> 44
2.0 -> 46
2.1 -> 49
2.2 -> 51
2.3 -> 54
2.4 -> 56
2.5 -> 59
2.6 -> 61
2.7 -> 64
2.8 -> 66
2.9 -> 69
3.0 -> 71
3.1 -> 73
3.2 -> 76
3.3 -> 78
3.4 -> 81
3.5 -> 83
3.6 -> 86
3.7 -> 88
3.8 -> 90
3.9 -> 93
4.0 -> 95
4.1 -> 98
4.2 -> 100
4.3 -> 102
4.4 -> 105
4.5 -> 107
4.6 -> 109
4.7 -> 111
4.8 -> 114
4.9 -> 116
5.0 -> 118

KV = RPM/Tensão_de_fase
KV +/- 1059.97 / 4.7 = 225.53
