goncalo3377/Tese/INFO_Material/MT6835/Frequência Max de Amostragem.md

segundo o datasheet:
- cada ciclo de clock completo (inferior e superior) tem um período de 60 ns.
- para ler toda a comunicação é preciso um total de 24 ciclos de clock (60x24=1440ns).
$$
\frac{1}{1440 \cdot 10^{-9}} = 694444 Hz = 694kHz
$$
