goncalo3377/Tese/INFO_Material/datasheet_motorGM3506.jpeg

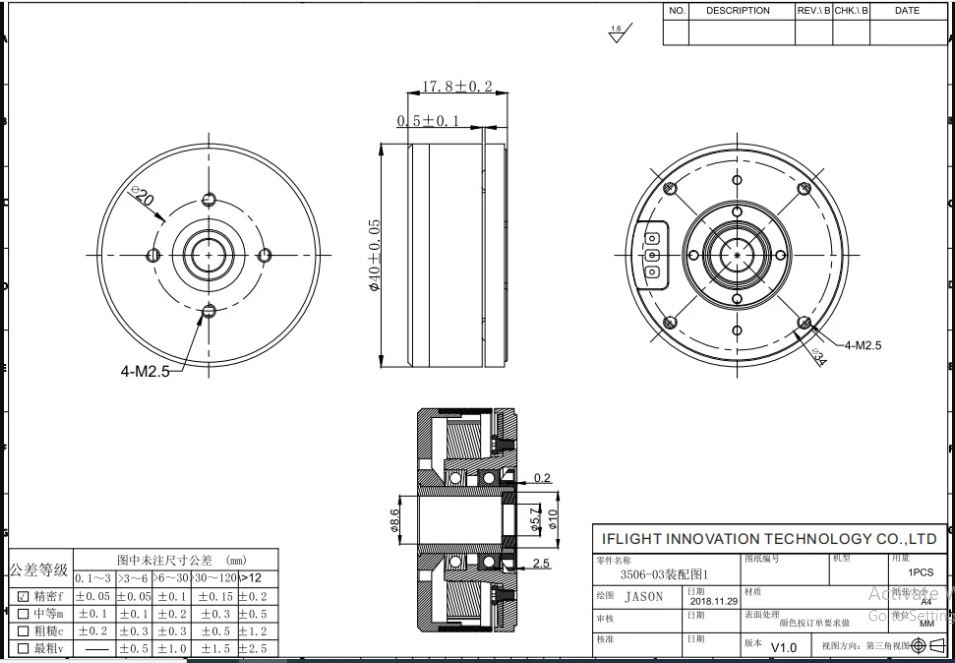
INFO_Material/datasheet_motorGM3506.jpeg
