goncalo3377/Tese/Modulation_3D/eixo_gimbal.stl

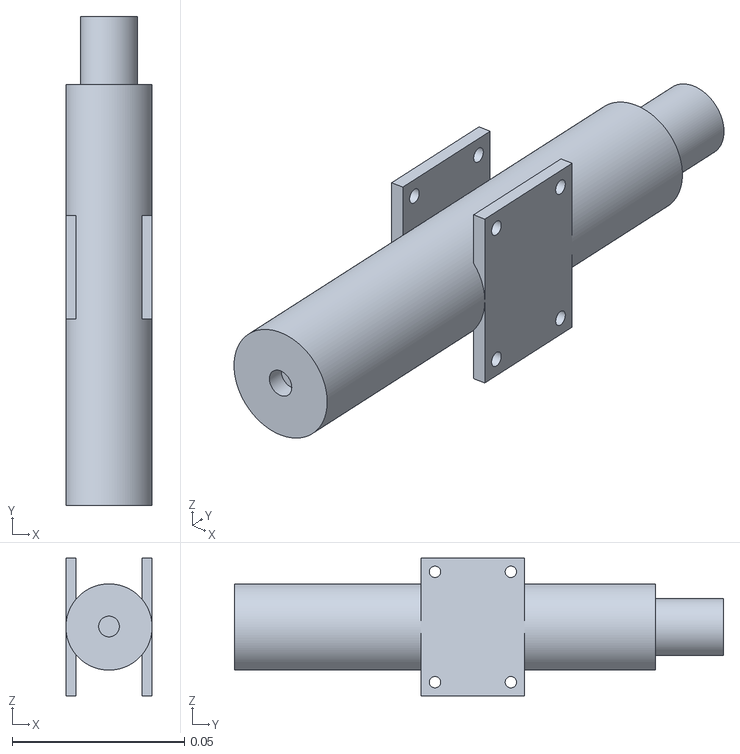
[picture p26: CAD file, 2026-03-04]
Modulation_3D/eixo_gimbal.stl
0.025 x 0.142 x 0.04
