goncalo3377/Tese/Modulation_3D/servo_conector.stl

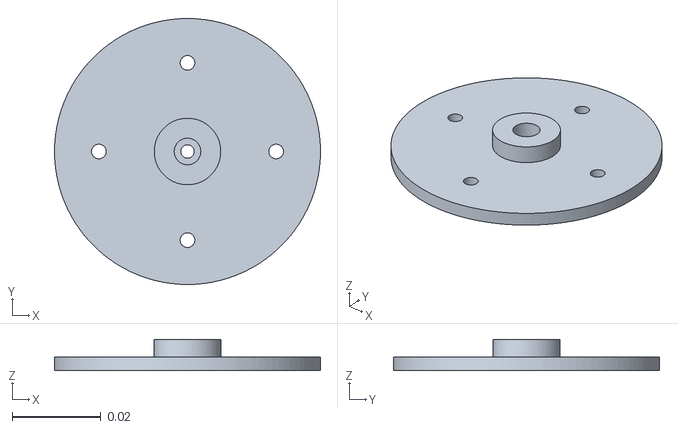
[picture p27: CAD file, 2026-03-04]
Modulation_3D/servo_conector.stl
0.06 x 0.06 x 0.007
