goncalo3377/Tese/Modulation_3D/extra_rolamento.stl

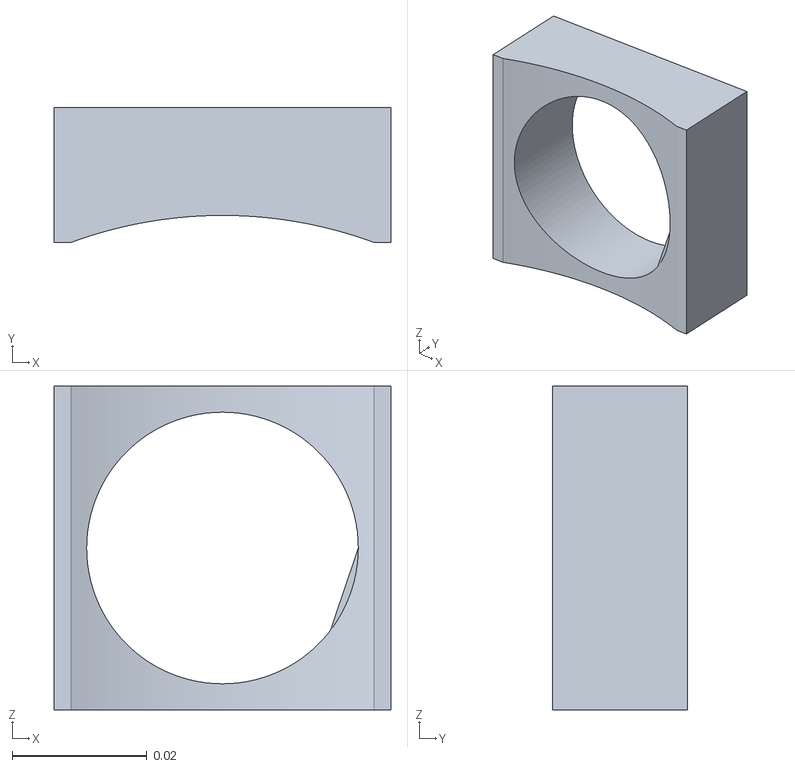
[picture p28: CAD file, 2026-03-04]
Modulation_3D/extra_rolamento.stl
0.05 x 0.02 x 0.048
