goncalo3377/Tese/Modulation_3D/gimbal_sistema.stl

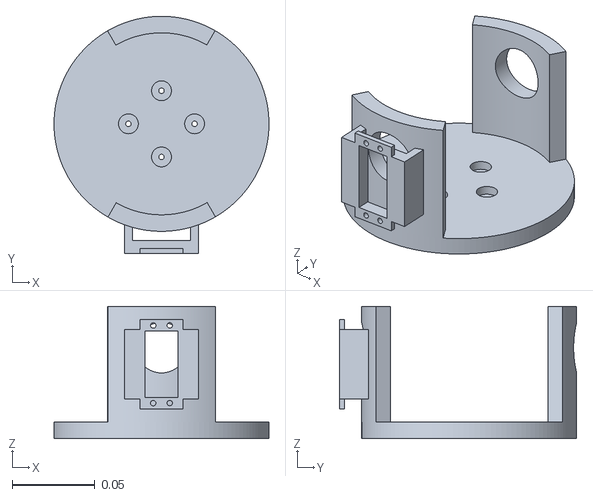
[picture p29: CAD file, 2026-03-04]
Modulation_3D/gimbal_sistema.stl
0.13 x 0.144 x 0.08
