goncalo3377/Tese/App debug/tensao/yaw/ensaio_motor_step_posição_PID.csv

Timestamp_ms | SP_Pitch | Pos_Pitch | Vel_Pitch | Vq_Pitch | Vd_Pitch | SP_Yaw | Pos_Yaw | Vel_Yaw | Vq_Yaw | Vd_Yaw
319459 | 3.1415927410125732 | 253.4329833984375 | -990.82763671875 | 8.0 | 0.0 | 3.1415927410125732 | 3.1411402225494385 | 0.04862484335899353 | -0.07637567073106766 | 0.0
319464 | 3.1415927410125732 | 254.13162231445312 | -929.0523681640625 | 8.0 | 0.0 | 3.1415927410125732 | 3.141146421432495 | 0.001269742613658309 | -0.0748303085565567 | 0.0
319469 | 3.1415927410125732 | 253.65127563476562 | -188.35067749023438 | -8.0 | 0.0 | 3.1415927410125732 | 3.1411702632904053 | 0.009836522862315178 | -0.0834193155169487 | 0.0
319474 | 3.1415927410125732 | 253.75057983398438 | -225.38478088378906 | 8.0 | 0.0 | 3.1415927410125732 | 3.1411821842193604 | 0.004823120776563883 | -0.07625468820333481 | 0.0
319479 | 3.1415927410125732 | 253.71047973632812 | -29.930944442749023 | 8.0 | 0.0 | 3.1415927410125732 | 3.1411972045898438 | 0.006535596679896116 | -0.07693693041801453 | 0.0
319484 | 3.1415927410125732 | 253.78721618652344 | 1168.9154052734375 | 8.0 | 0.0 | 3.1415927410125732 | 3.1412031650543213 | 0.002786566037684679 | -0.07270693778991699 | 0.0
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
