goncalo3377/Tese/App debug/tensao/yaw/ensaio_motor_step_velocidade_PID.csv

Timestamp_ms | SP_Pitch | Pos_Pitch | Vel_Pitch | Vq_Pitch | Vd_Pitch | SP_Yaw | Pos_Yaw | Vel_Yaw | Vq_Yaw | Vd_Yaw
190934 | 0.0 | 71.97638702392578 | -501.10784912109375 | -8.0 | 0.0 | 0.0 | 29.69565200805664 | -4.7068166168173775e-05 | 0.011754890903830528 | 0.0
190939 | 0.0 | 70.83540344238281 | -1129.15576171875 | -8.0 | 0.0 | 0.0 | 29.69565200805664 | -4.7068166168173775e-05 | 0.01175734307616949 | 0.0
190944 | 0.0 | 72.01677703857422 | -2134.470458984375 | -8.0 | 0.0 | 0.0 | 29.69565200805664 | -4.7068166168173775e-05 | 0.01175979245454073 | 0.0
190949 | 0.0 | 71.12694549560547 | -83.75709533691406 | -8.0 | 0.0 | 0.0 | 29.69565200805664 | -4.7068166168173775e-05 | 0.011762242764234543 | 0.0
190954 | 0.0 | 70.99199676513672 | -708.5726928710938 | -8.0 | 0.0 | 0.0 | 29.69565200805664 | -4.7068166168173775e-05 | 0.01176469400525093 | 0.0
190959 | 0.0 | 71.46461486816406 | 2468.23046875 | 8.0 | 0.0 | 0.0 | 29.69565200805664 | -4.7068166168173775e-05 | 0.011767146177589893 | 0.0
190964 | 0.0 | 71.0301284790039 | 2475.577880859375 | 8.0 | 0.0 | 0.0 | 29.69565200805664 | -4.7068166168173775e-05 | 0.011769594624638557 | 0.0
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
