goncalo3377/Tese/App debug/tensao/pitch/7v/step/ensaio_motor_seno_7v_1780501895.csv

Timestamp_ms | SP_Pitch | Pos_Pitch | Vel_Pitch | Vq_Pitch | Vd_Pitch | SP_Yaw | Pos_Yaw | Vel_Yaw | Vq_Yaw | Vd_Yaw
103029 | 0.0 | 213.56658935546875 | -0.009731370955705643 | 0.0 | 0.0 | 0.0 | 3.1631104946136475 | -0.005068422295153141 | 0.0 | 0.0
103034 | 0.0 | 213.5665740966797 | -0.00020522132399491966 | 0.0 | 0.0 | 0.0 | 3.1630773544311523 | -0.04066671431064606 | 0.0 | 0.0
103039 | 0.0 | 213.5665740966797 | -0.00020522132399491966 | 0.0 | 0.0 | 0.0 | 3.163074493408203 | -0.0016218950040638447 | 0.0 | 0.0
103044 | 0.0 | 213.5665740966797 | -0.00020522132399491966 | 0.0 | 0.0 | 0.0 | 3.1630594730377197 | -0.0024273383896797895 | 0.0 | 0.0
103049 | 0.0 | 213.5665740966797 | -0.00020522132399491966 | 0.0 | 0.0 | 0.0 | 3.163053512573242 | -0.0020266794599592686 | 0.0 | 0.0
103054 | 0.0 | 213.5665740966797 | -0.00020522132399491966 | 0.0 | 0.0 | 0.0 | 3.163053512573242 | -0.0020266794599592686 | 0.0 | 0.0
103059 | 0.0 | 213.5665740966797 | -0.00020522132399491966 | 0.0 | 0.0 | 0.0 | 3.163053512573242 | -0.0020266794599592686 | 0.0 | 0.0
103064 | 0.0 | 213.5665740966797 | -0.00020522132399491966 | 0.0 | 0.0 | 0.0 | 3.163053512573242 | -0.0020266794599592686 | 0.0 | 0.0
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
