goncalo3377/Tese/Motor_Controller/Diatancia_teste_resolução.pdf

# ArcGIS Web Map

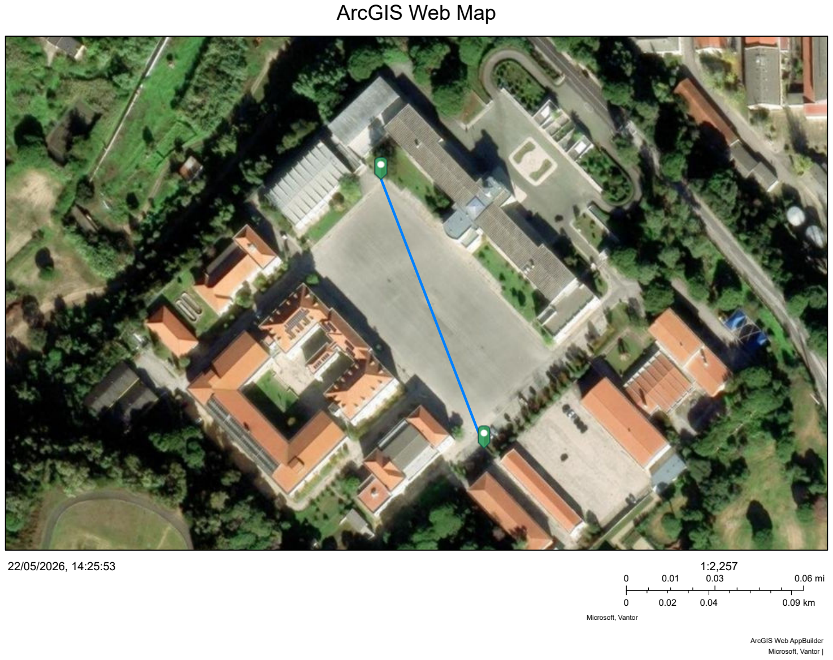
[picture p30: page 1]

Microsoft, Vantor

22/05/2026, 14:25:53
0 | 0.01 | 0.03 | 0.06 mi
0 | 0.02 | 0.04 | 0.09 km

1:2,257

ArcGIS Web AppBuilder
Microsoft, Vantor |
