goncalo3377/Tese/App debug/Requesitos interface debug gimbal.md

### Tem de mostrar:
	velocidade atual
	posição (0 360 ou 0 2pi)
	valores de tensao d e q
### Possível alterar:
	PID
	passa-baixo
	tensão max
	velocidade max

## deve conter:
	gráficos
	exportação .csv
