goncalo3377/Tese/App debug/ensaio_motor_1779897435.ods

Timestamp_ms | SP_Pitch | Pos_Pitch | Vel_Pitch | Vq_Pitch | Vd_Pitch | SP_Yaw | Pos_Yaw | Vel_Yaw | Vq_Yaw | Vd_Yaw
985199 | -0,249406337738037 | 31,4185009002686 | -0,2472934871912 | -0,249406337738037 | 0 | -0,249406337738037 | 0,940489053726196 | -0,874958336353302 | -0,249406337738037 | 0
985209 | -0,261881768703461 | 31,4151763916016 | -0,326804280281067 | -0,261881768703461 | 0 | -0,261881768703461 | 0,933217585086823 | -0,824034214019775 | -0,261881768703461 | 0
985219 | -0,274346858263016 | 31,4114723205566 | -0,48594868183136 | -0,274346858263016 | 0 | -0,274346858263016 | 0,925254106521606 | -0,86549723148346 | -0,274346858263016 | 0
985229 | -0,286801099777222 | 31,4076614379883 | -0,476837158203125 | -0,286801099777222 | 0 | -0,286801099777222 | 0,917173743247986 | -0,737352192401886 | -0,286801099777222 | 0
985239 | -0,299243956804276 | 31,4033622741699 | -0,353831380605698 | -0,299243956804276 | 0 | -0,299243956804276 | 0,908610999584198 | -0,906408190727234 | -0,299243956804276 | 0
985249 | -0,311675012111664 | 31,398811340332 | -0,572503507137299 | -0,311675012111664 | 0 | -0,311675012111664 | 0,900180101394653 | -0,842660665512085 | -0,311675012111664 | 0
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
