goncalo3377/Tese/App debug/ensaio_motor_triangular_0.1hz_1rad.ods

Timestamp_ms | SP_Pitch | Pos_Pitch | Vel_Pitch | Vq_Pitch | Vd_Pitch | SP_Yaw | Pos_Yaw | Vel_Yaw | Vq_Yaw | Vd_Yaw
946109 | 0 | 4166.24951171875 | 2210.87353515625 | -8 | 0 | -0.443603515625 | -0.418240547180176 | -0.383033126592636 | -0.37997117638588 | 0
946114 | 0 | 4165.36328125 | -337.288024902344 | -8 | 0 | -0.445605516433716 | -0.420026302337647 | -0.450346201658249 | -0.467734783887863 | 0
946119 | 0 | 4165.43017578125 | 704.751281738281 | -8 | 0 | -0.447607517242432 | -0.42183256149292 | -0.431498557329178 | -0.46036297082901 | 0
946124 | 0 | 4165.29736328125 | -996.669128417969 | -8 | 0 | -0.449609279632568 | -0.423666477203369 | -0.422118157148361 | -0.374837517738342 | 0
946129 | 0 | 4166.64404296875 | 197.484268188477 | 8 | 0 | -0.451611280441284 | -0.425604820251465 | -0.412737756967545 | -0.429308146238327 | 0
946134 | 0 | 4165.6435546875 | -868.055541992188 | 8 | 0 | -0.453588962554932 | -0.427474498748779 | -0.423681557178497 | -0.441482156515121 | 0
946139 | 0 | 4165.4345703125 | -792.275085449219 | -0.527280807495117 | 0 | -0.455590724945068 | -0.429385662078857 | -0.333004325628281 | -0.497010141611099 | 0
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
