goncalo3377/Tese/App debug/ensaio_Yaw_Triangular_P10_3_I14_3_D1_74_F0_01.ods

Timestamp_ms | SP_Pitch | Pos_Pitch | Vel_Pitch | Vq_Pitch | Vd_Pitch | SP_Yaw | Pos_Yaw | Vel_Yaw | Vq_Yaw | Vd_Yaw
4862094 | 0 | 2.21559858322144 | -2.24971461296082 | 0 | 0 | 0.837695300579071 | 0.83980655670166 | 0.259043037891388 | 0.315889567136765 | 0
4862099 | 0 | 2.21553874015808 | -2.57800221443176 | 0 | 0 | 0.839648425579071 | 0.841388463973999 | 0.456006497144699 | 0.310809463262558 | 0
4862104 | 0 | 2.21541285514832 | -0.703091502189636 | 0 | 0 | 0.841601550579071 | 0.842922449111939 | 0.315864086151123 | 0.320177882909775 | 0
4862109 | 0 | 2.21575736999512 | 0.725155472755432 | 0 | 0 | 0.843554675579071 | 0.844633221626282 | 0.414757609367371 | 0.315850645303726 | 0
4862114 | 0 | 2.21525716781616 | -0.434763312339783 | 0 | 0 | 0.845507800579071 | 0.84620612859726 | 0.3316410779953 | 0.312088489532471 | 0
4862119 | 0 | 2.21517610549927 | -0.570059657096863 | 0 | 0 | 0.84765625 | 0.847794055938721 | 0.342159539461136 | 0.315704107284546 | 0
4862124 | 0 | 2.21608686447144 | -0.30572721362114 | 0 | 0 | 0.849609375 | 0.849417924880981 | 0.285453528165817 | 0.31230166554451 | 0
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
