goncalo3377/Tese/App debug/quadrada_posição_fechada/ensaio_motor_1779896869.csv

Timestamp_ms | SP_Pitch | Pos_Pitch | Vel_Pitch | Vq_Pitch | Vd_Pitch | SP_Yaw | Pos_Yaw | Vel_Yaw | Vq_Yaw | Vd_Yaw
438209 | -1.0 | -1.0005240440368652 | 0.00034835294354707 | -0.6286236047744751 | 0.0 | -1.0 | -0.9998860359191895 | -0.0003641047514975071 | -0.273068368434906 | 0.0
438219 | -1.0 | -1.0005240440368652 | 0.00034835294354707 | -0.6276023387908936 | 0.0 | -1.0 | -0.9998860359191895 | -0.0003641047514975071 | -0.27326148748397827 | 0.0
438229 | -1.0 | -1.000521183013916 | 6.52531161904335e-05 | -0.6264864206314087 | 0.0 | -1.0 | -0.9998860359191895 | -0.0003641047514975071 | -0.2734537124633789 | 0.0
438239 | -1.0 | -1.0005059242248535 | 0.0011157348053529859 | -0.6259779334068298 | 0.0 | -1.0 | -0.9998860359191895 | -0.0003641047514975071 | -0.27364012598991394 | 0.0
438249 | -1.0 | -1.0005059242248535 | 0.0011157348053529859 | -0.6252039670944214 | 0.0 | -1.0 | -0.9998860359191895 | -0.0003641047514975071 | -0.2738322615623474 | 0.0
438259 | -1.0 | -1.0005059242248535 | 0.0011157348053529859 | -0.6243452429771423 | 0.0 | -1.0 | -0.9998860359191895 | -0.0003641047514975071 | -0.2740246653556824 | 0.0
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
