goncalo3377/Tese/App debug/quadrada_posição_fechada/ensaio_motor_1779896869.ods

Timestamp_ms | SP_Pitch | Pos_Pitch | Vel_Pitch | Vq_Pitch | Vd_Pitch | SP_Yaw | Pos_Yaw | Vel_Yaw | Vq_Yaw | Vd_Yaw
438209 | -1 | -1,00052404403687 | 0,00034835294354707 | -0,628623604774475 | 0 | -1 | -0,99988603591919 | -0,000364104751497507 | -0,273068368434906 | 0
438219 | -1 | -1,00052404403687 | 0,00034835294354707 | -0,627602338790894 | 0 | -1 | -0,99988603591919 | -0,000364104751497507 | -0,273261487483978 | 0
438229 | -1 | -1,00052118301392 | 6,52531161904335E-05 | -0,626486420631409 | 0 | -1 | -0,99988603591919 | -0,000364104751497507 | -0,273453712463379 | 0
438239 | -1 | -1,00050592422485 | 0,00111573480535299 | -0,62597793340683 | 0 | -1 | -0,99988603591919 | -0,000364104751497507 | -0,273640125989914 | 0
438249 | -1 | -1,00050592422485 | 0,00111573480535299 | -0,625203967094421 | 0 | -1 | -0,99988603591919 | -0,000364104751497507 | -0,273832261562347 | 0
438259 | -1 | -1,00050592422485 | 0,00111573480535299 | -0,624345242977142 | 0 | -1 | -0,99988603591919 | -0,000364104751497507 | -0,274024665355682 | 0
438269 | -1 | -1,00050592422485 | 0,00111573480535299 | -0,623444974422455 | 0 | -1 | -0,99988603591919 | -0,000364104751497507 | -0,274216800928116 | 0
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
