goncalo3377/Tese/App debug/tensao/Bode_Pitch.png

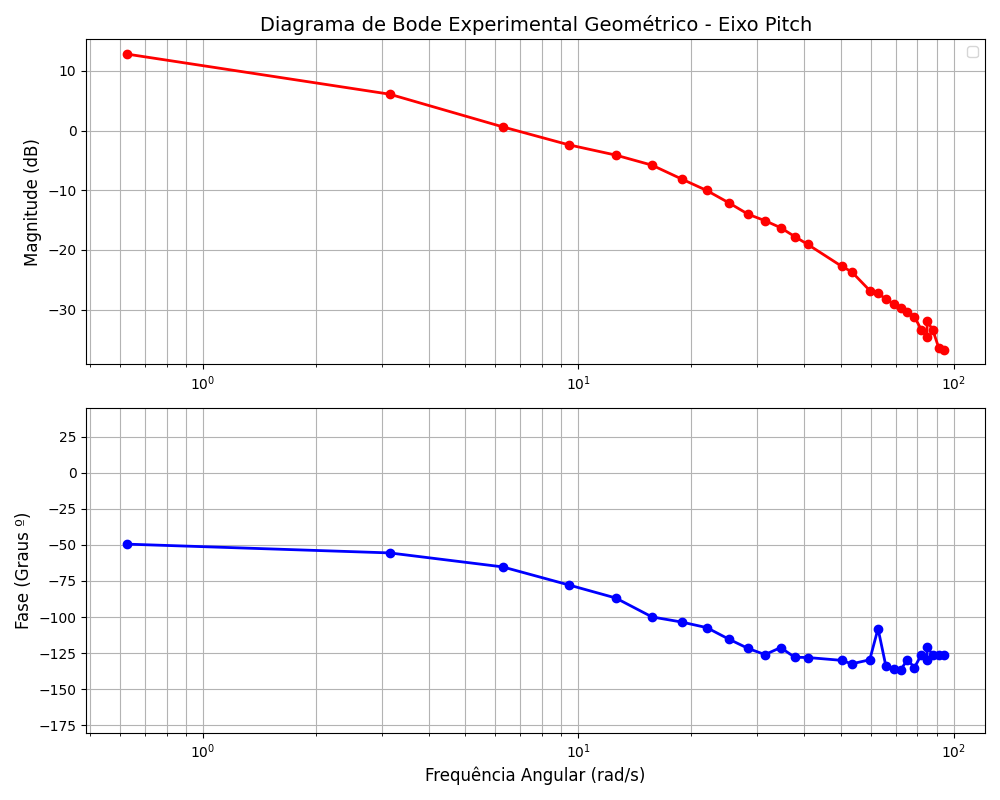
App debug/tensao/Bode_Pitch.png
