goncalo3377/Tese/App debug/tensao/pitch/7v/ensaio_1/Figure_1.png

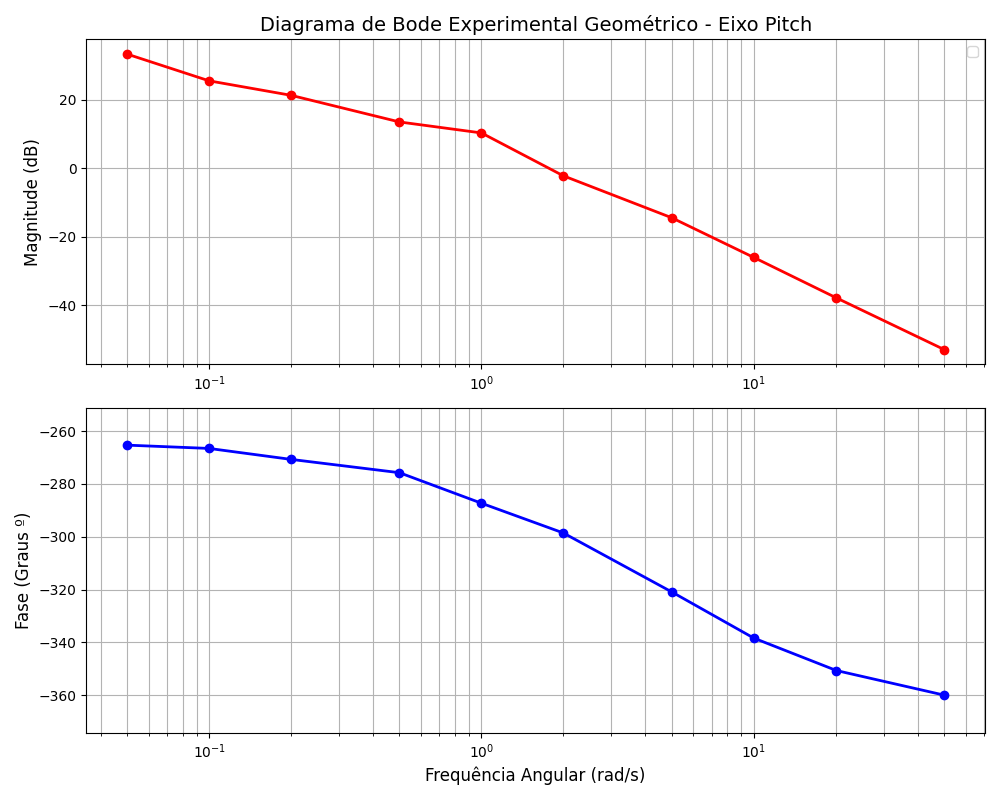
App debug/tensao/pitch/7v/ensaio_1/Figure_1.png
