goncalo3377/Tese/App debug/tensao/yaw/bode_yaw.png

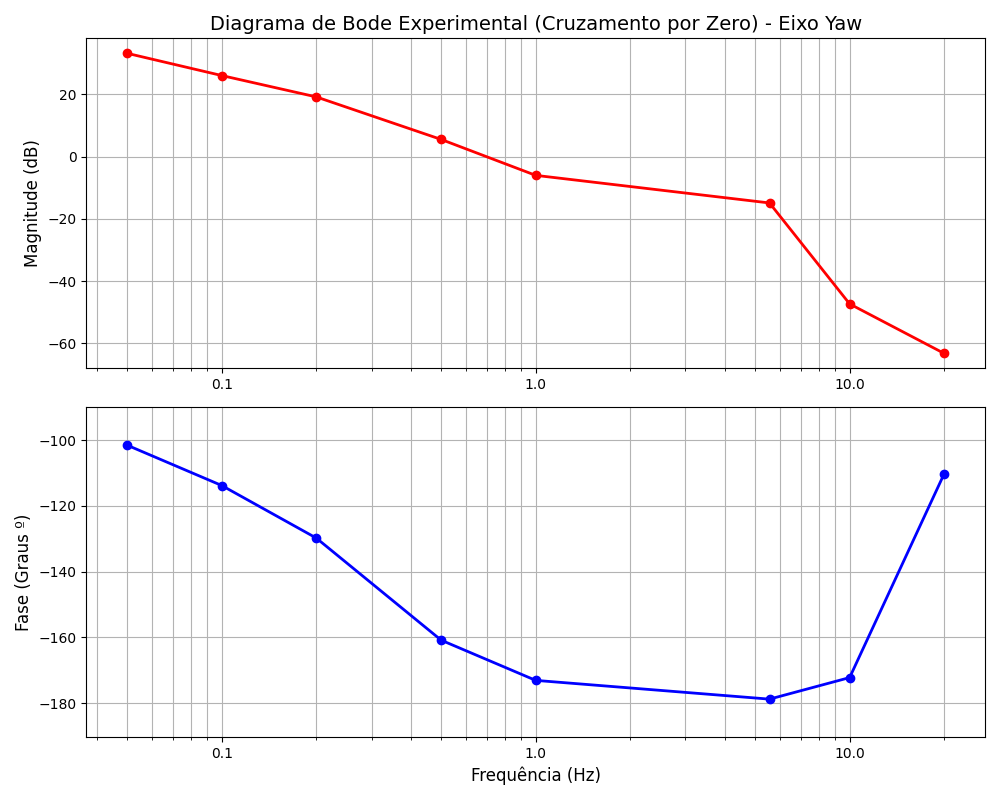
App debug/tensao/yaw/bode_yaw.png
