goncalo3377/Tese/App debug/tensao/yaw/ensaio_1/Figure_1.png

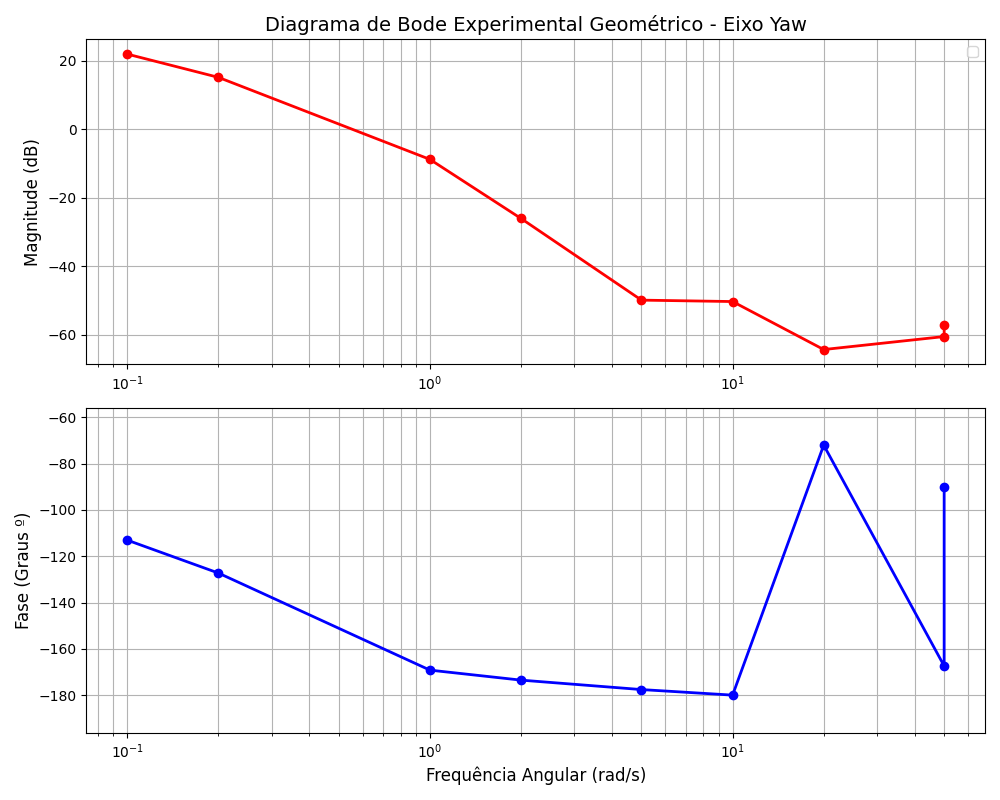
App debug/tensao/yaw/ensaio_1/Figure_1.png
