goncalo3377/Tese/Motor_Controller/tese_controlo.pdf

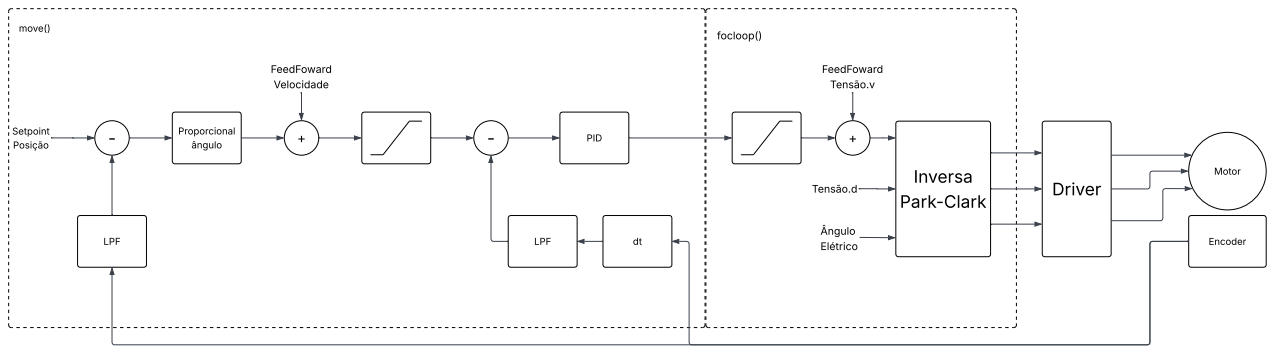
[picture p35: page 1]
clo; cio; al ângulo; PID; Cla; ulo; Elé; ric; oin; siç; elo; cid; riv
