goncalo3377/Tese/Document_Dissertacao/chapters/ch5_Estrutura/assets/Diagrama_Processamento.pdf

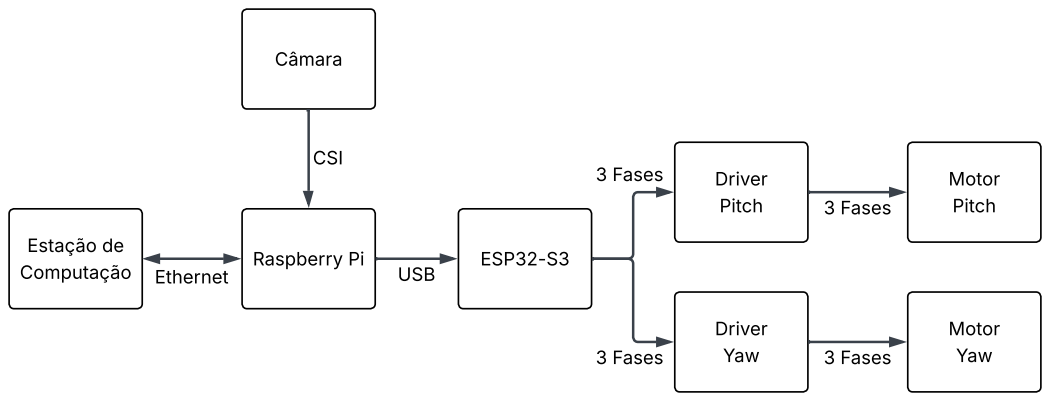
[picture p36: page 1]
Estação de Computação; Raspberry Pi; Câmara; ESP32-S3; Driver Pitch; Motor Pitch; Driver Yaw; Motor Yaw; CSI; Ethernet; USB; 3 Fases
