goncalo3377/Tese/Document_Dissertacao/chapters/ch6_Controlo/assets/simulink_contolo_seguimento.pdf

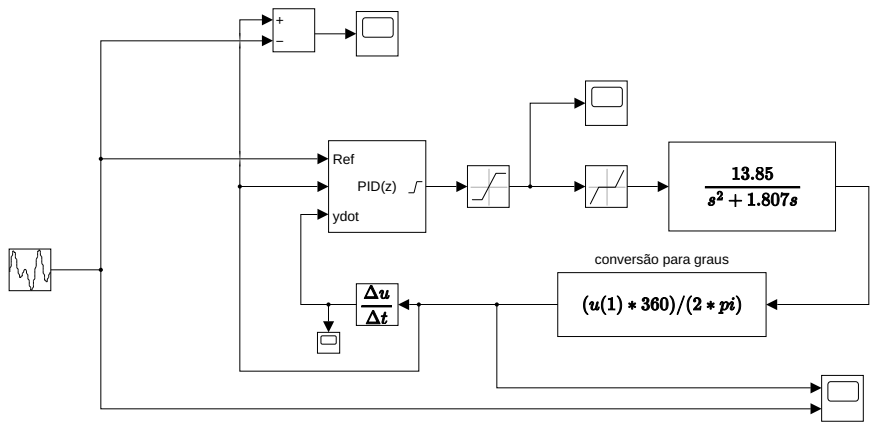
[picture p37: page 1]
PID(z); Ref; ydot

conversão para graus
