goncalo3377/Tese/Document_Dissertacao/chapters/ch6_Controlo/assets/tese_controlo_varrimento.pdf

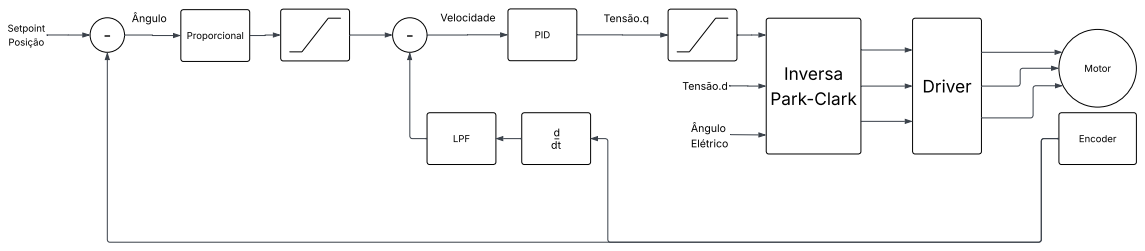
[picture p38: page 1]
cio; PID; Cla; ulo; Elé; ric; oin; siç; riv; elo; cid
