goncalo3377/Tese/App debug/tensao/pitch/Figure_1.pdf

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

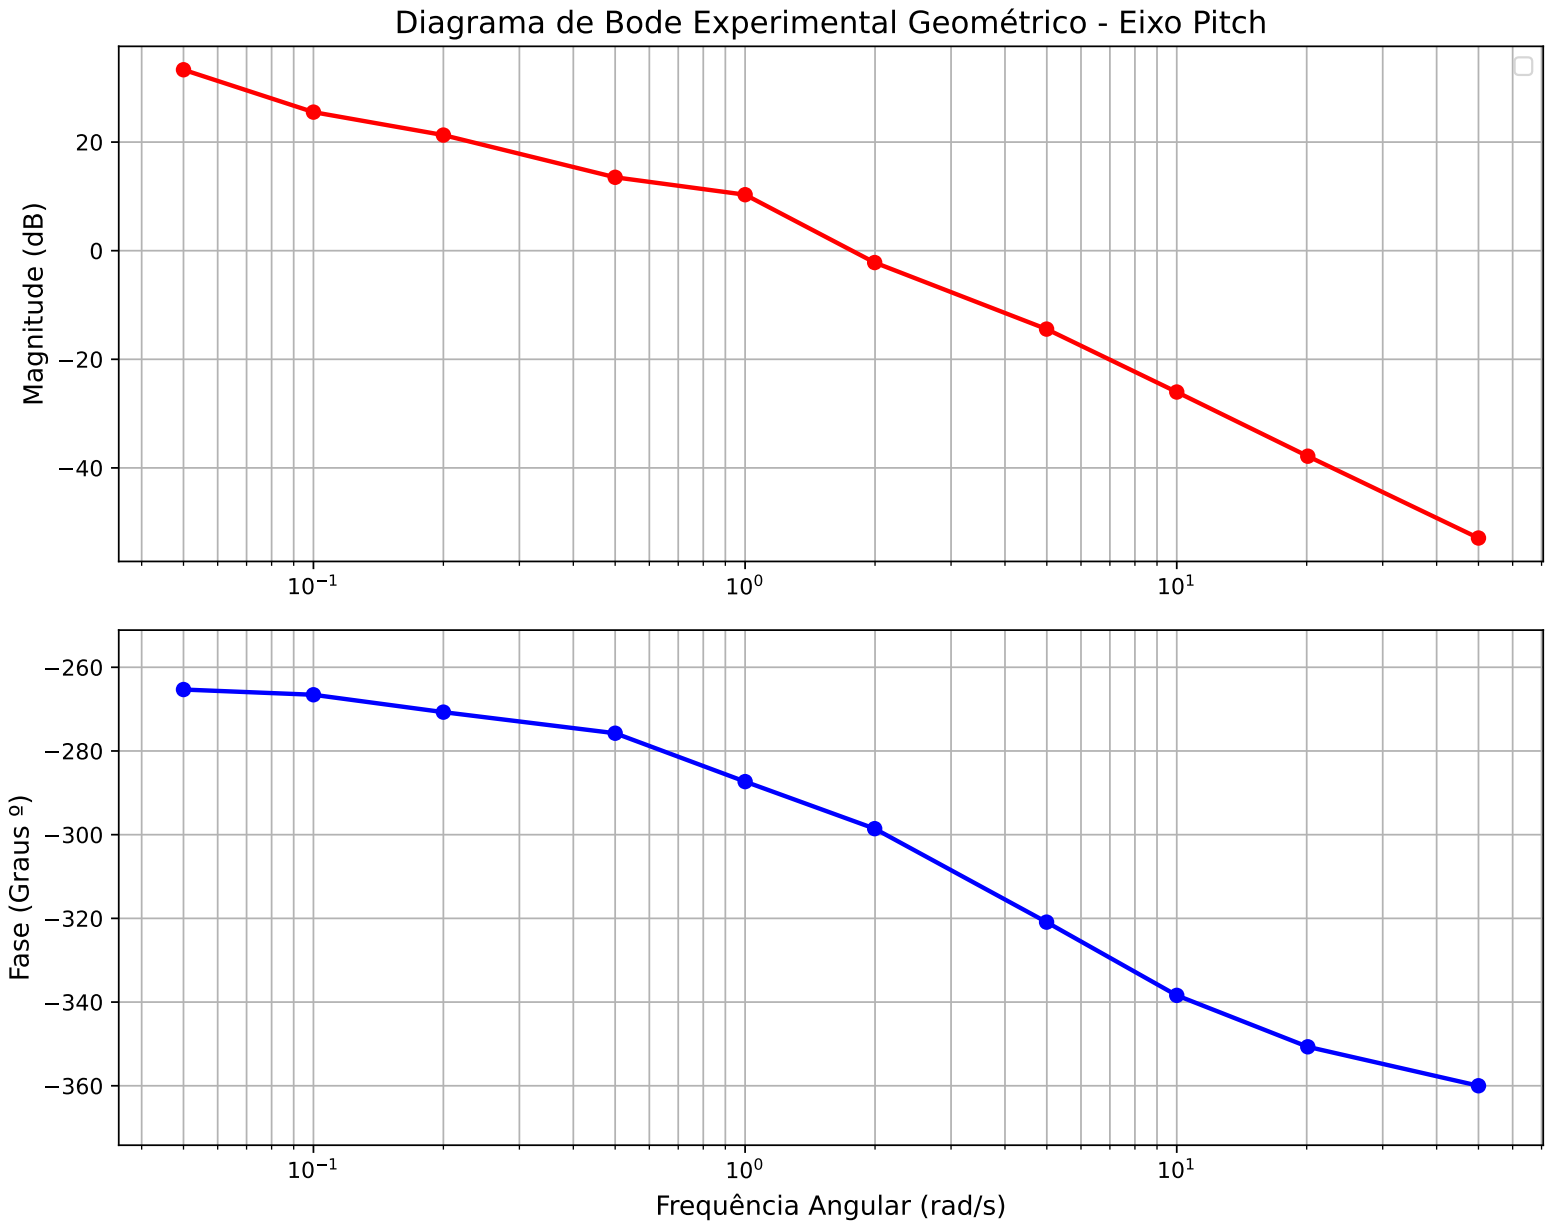
[picture p39: page 1]
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
