goncalo3377/Tese/App debug/tensao/yaw/bode_yaw.pdf

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

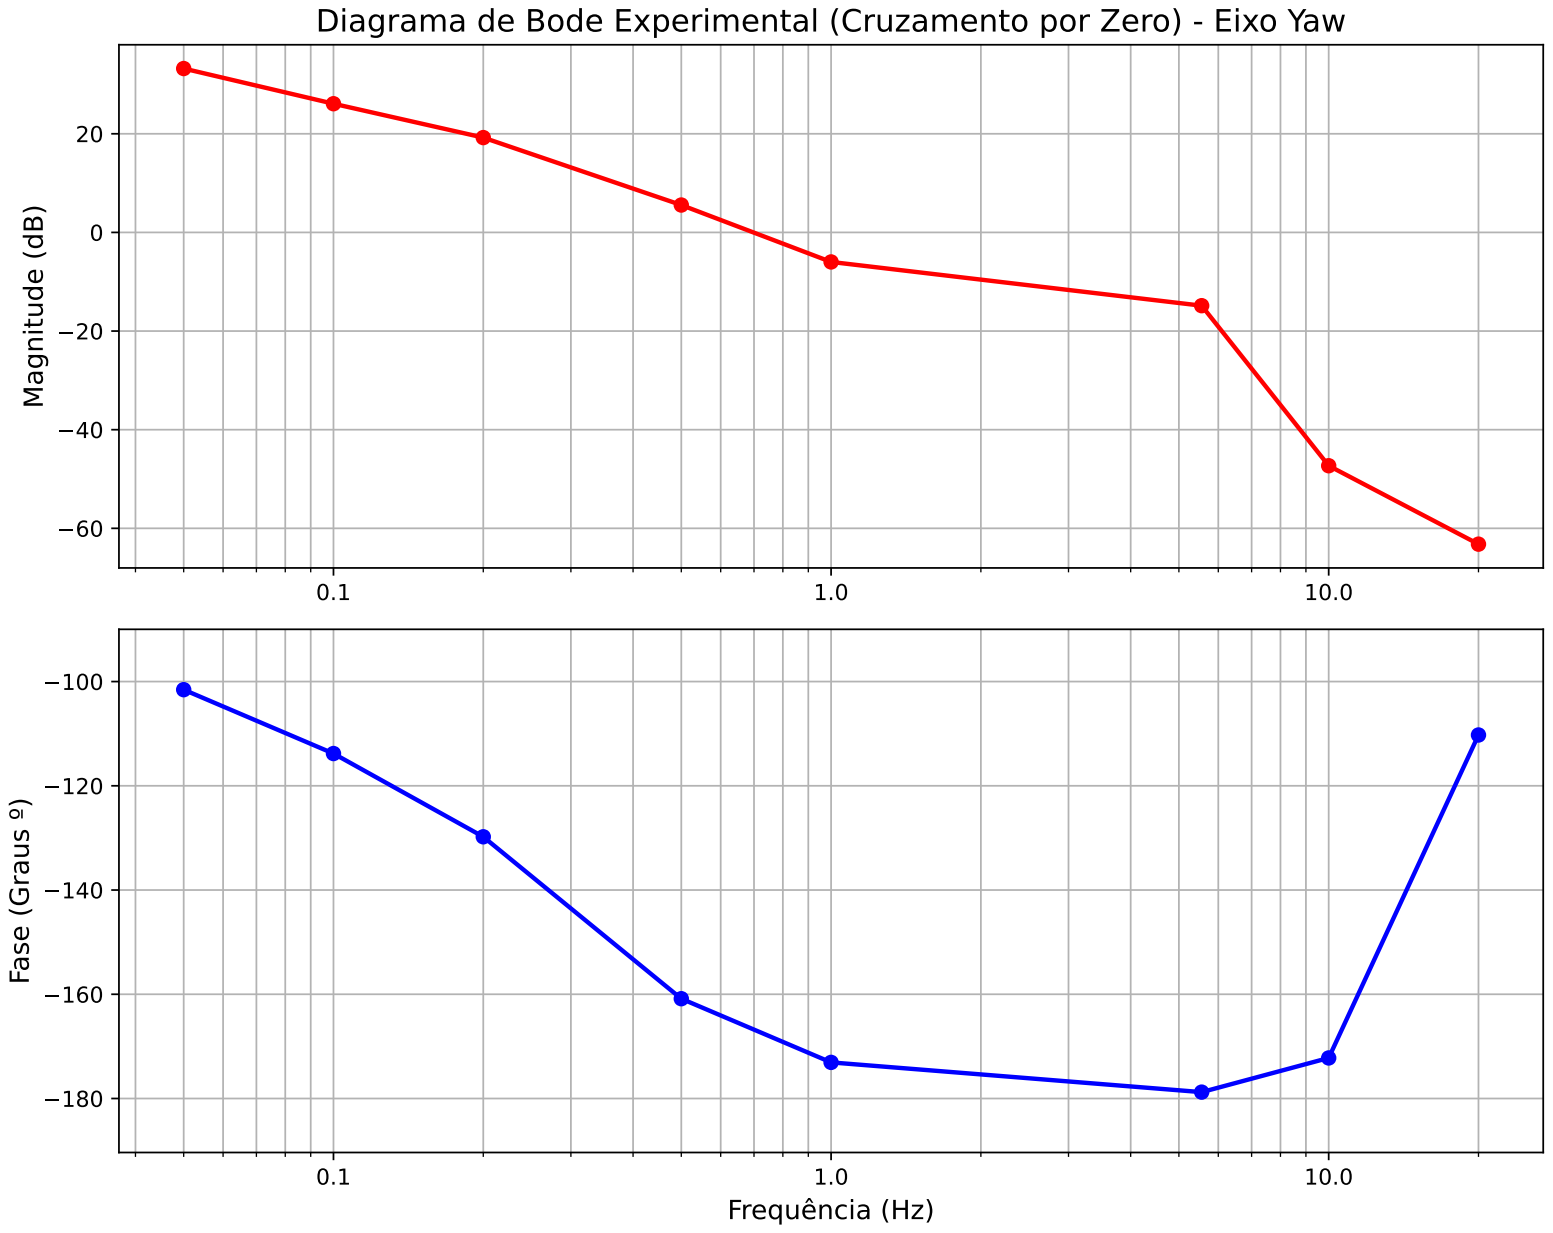
[picture p40: page 1]
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
