goncalo3377/Tese/Document_Dissertacao/chapters/ch6_Controlo/assets/tese_controlo_seguimento.pdf

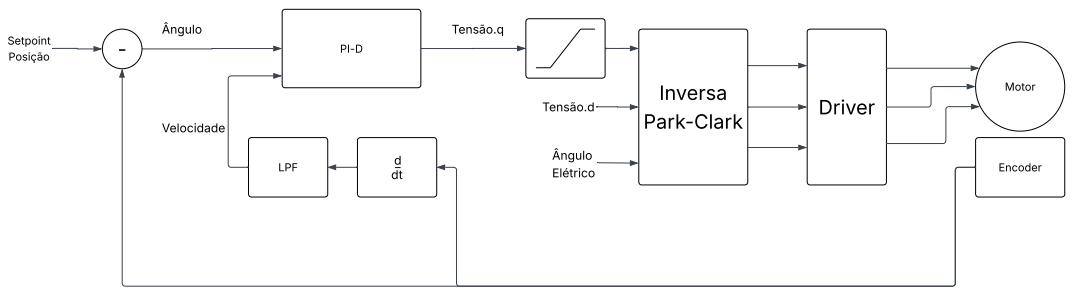
[picture p50: page 1]
Cla; ulo; Elé; ric; oin; siç; riv; elo; cid
