goncalo3377/Tese/Document_Dissertacao/chapters/ch6_Controlo/assets/diagrama_bode_pitch.pdf

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

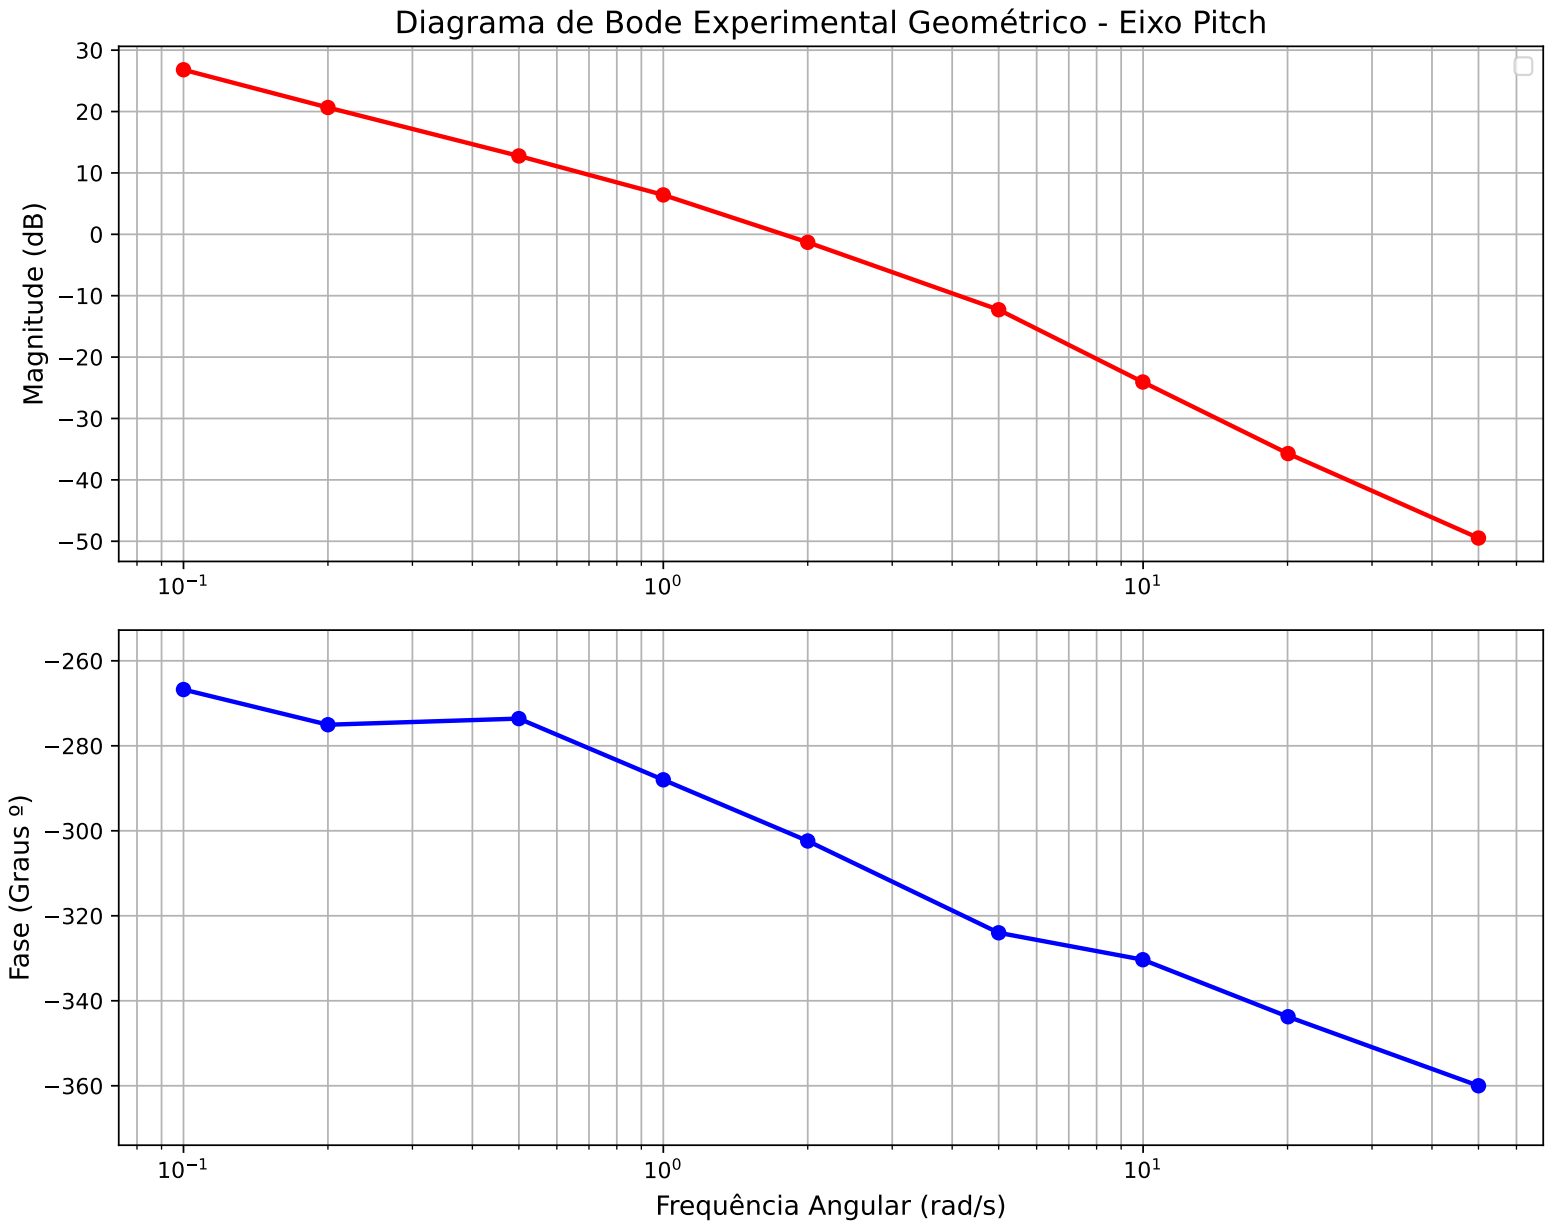
[picture p51: page 1]
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
