goncalo3377/Tese/(commit log)

2026-03-25 trash files
    [Base_inferior.3mf, Base_inferior.stl, eixo_gimbal.stl, extra_rolamento.stl, gimbal_sistema.stl, servo_conector.stl]
2026-03-25 Motor Charasteristics and PlataformIO environment
2026-03-25 openloop motor code
2026-03-25 read magnetic encoder MT6835
2026-05-13 motor pitch working
2026-05-13 remove issue that makes the motor rotate to 0 rad from the long path, now the 0 rad is in pi so the encoder stay between the correct range
    [main.cpp]
2026-05-14 working with 2 motors
2026-05-20 comunication with pc with python application. Only export data from 1 motor
2026-05-27 resolving low responsive issue
    [app.py, communication.py, main.cpp]
2026-06-15 tests to make the bode diagram
    [ensaio_motor_1780417917.csv, ensaio_motor_1780418349.csv, ensaio_motor_seno_7v_1780418504.csv, ensaio_motor_seno_7v_1780418601.csv, ensaio_motor_seno_7v_1780418863.csv, ensaio_motor_seno_7v_1780419017.csv, ensaio_motor_seno_7v_1780419033.csv, ensaio_motor_seno_7v_1780419043qqq.csv]
2026-07-02 3D Model Parts
    [eixo_gimbal.stl, extra_rolamento.stl, gimbal_sistema.stl, servo_conector.stl]
2026-07-02 motors and gimbal caracteristics
2026-07-02 matlab file to tuning PID
2026-07-02 experimental tests and others things in python app
    [ensaio_Yaw_Triangular_P10_3_I14_3_D1_74_F0_01.csv, ensaio_Yaw_Triangular_P10_3_I14_3_D1_74_F0_01.ods, ensaio_Yaw_Triangular_P4_3_I4_3_D0_95_F0_03.csv, ensaio_motor_1779885140.csv, ensaio_motor_1779885167.csv, ensaio_motor_1779885204.csv, ensaio_motor_1779885531.csv, ensaio_motor_1779885551.csv]
